craigyjp/Elka-X-VST-editor---Cherry-Audio/schematics/Synthex-Main.pdf

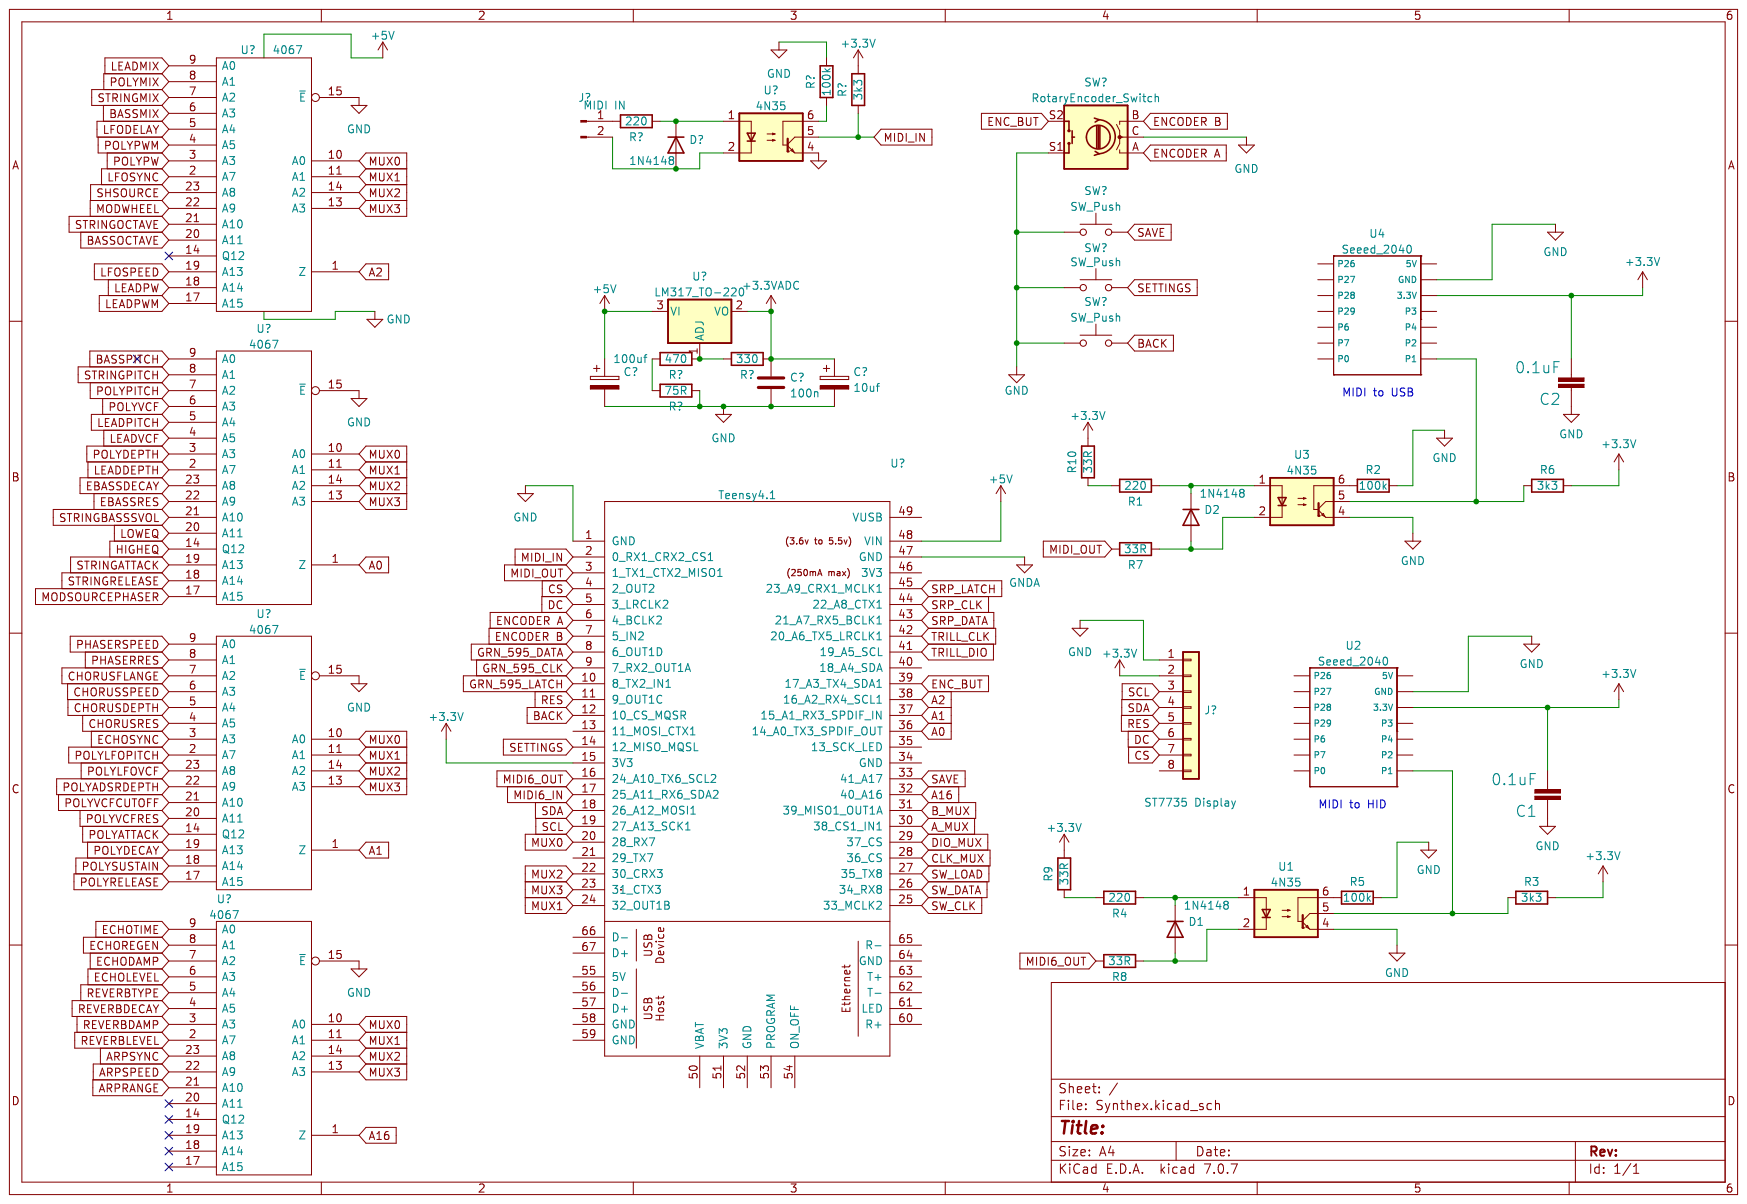
[picture p2: page 1]
