craigyjp/Elka-X-VST-editor---Cherry-Audio/schematics/Synthex-LED-DISPLAYS.pdf

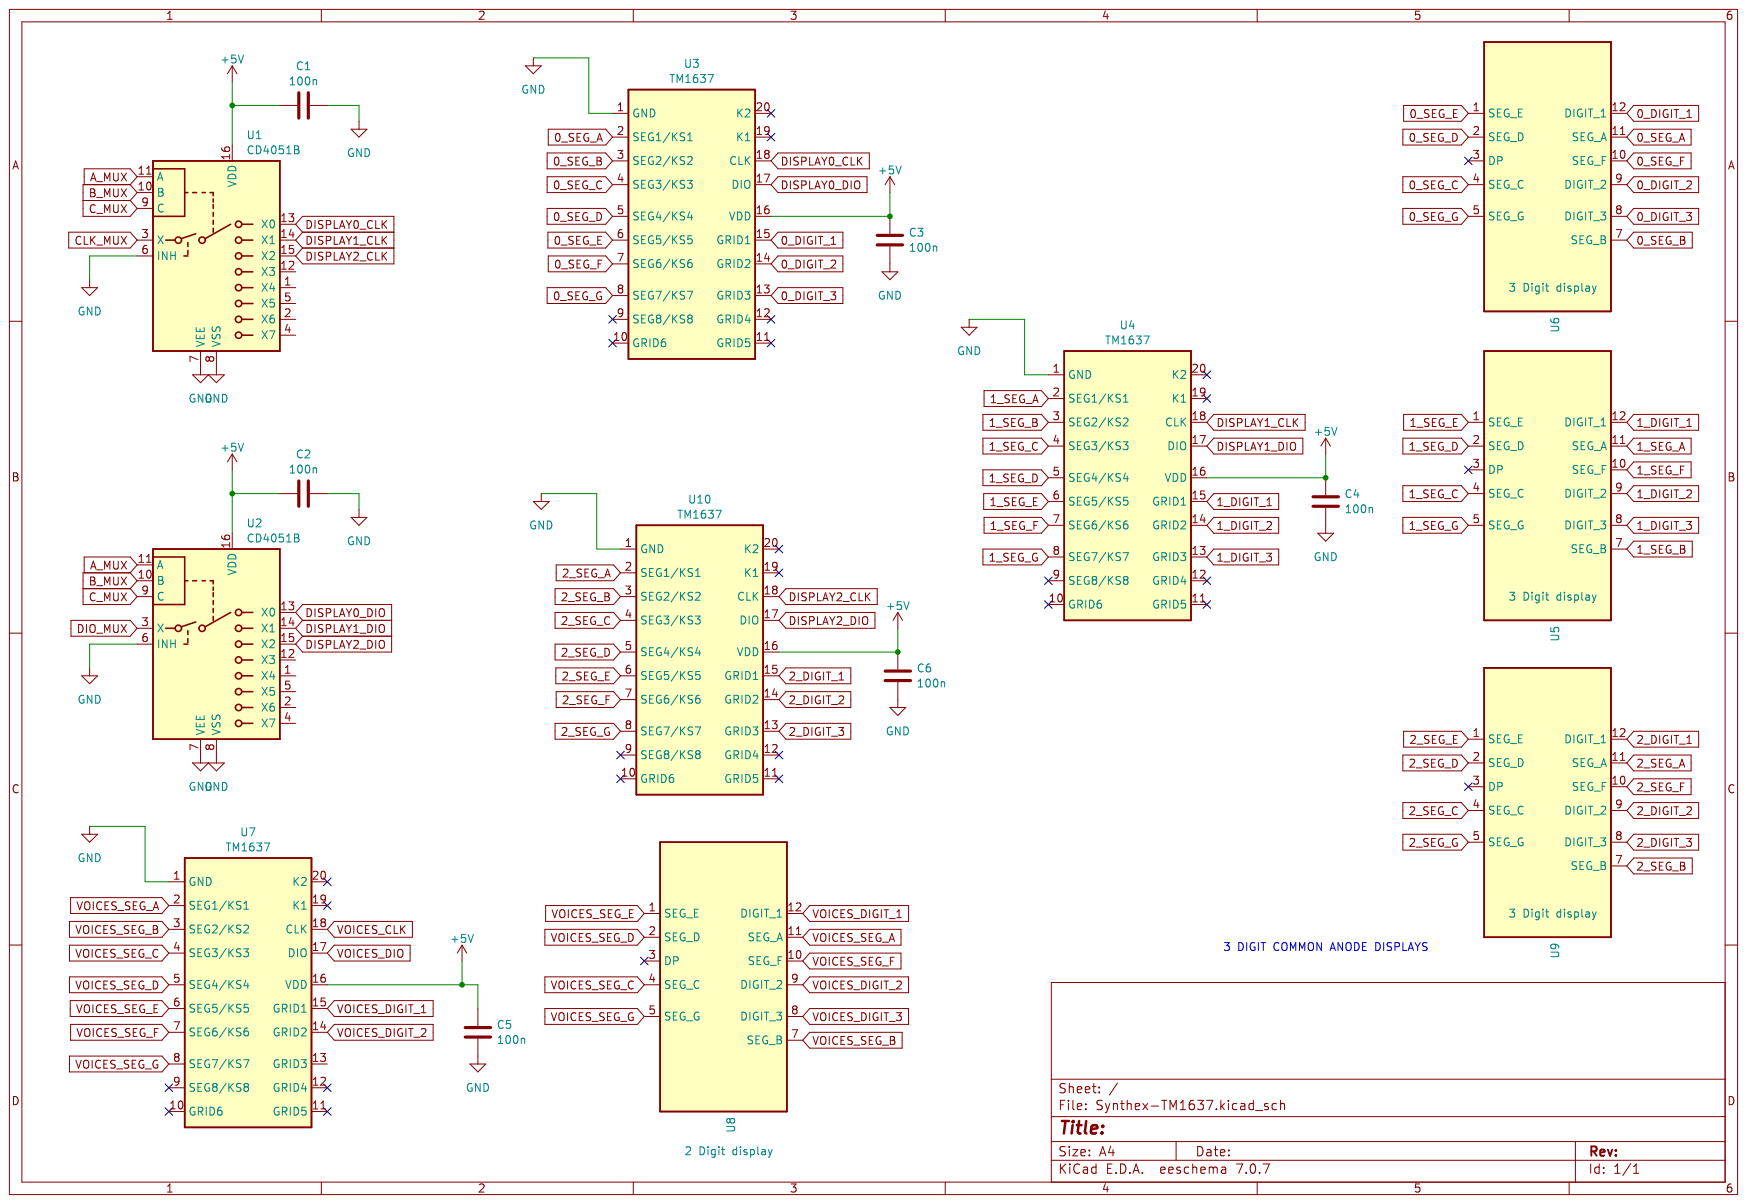
[picture p3: page 1]
