craigyjp/Elka-X-VST-editor---Cherry-Audio/src/Synthex.ino

/*
  Synthex Editor - Firmware Rev 1.0

  Includes code by:
    Dave Benn - Handling MUXs, a few other bits and original inspiration  https://www.notesandvolts.com/2019/01/teensy-synth-part-10-hardware.html
    ElectroTechnique for general method of menus and updates.

  Arduino IDE
  Tools Settings:
  Board: "Teensy4,1"
  USB Type: "Serial + MIDI"
  CPU Speed: "600"
  Optimize: "Fastest"

  Additional libraries:
    Agileware CircularBuffer available in Arduino libraries manager
    Replacement files are in the Modified Libraries folder and need to be placed in the teensy Audio folder.
*/

#include <Wire.h>
#include <SPI.h>
#include <SD.h>
#include <SerialFlash.h>
#include <MIDI.h>
#include <USBHost_t36.h>
#include "MidiCC.h"
#include "ButtonsPots.h"
#include "Constants.h"
#include "Parameters.h"
#include "PatchMgr.h"
#include "HWControls.h"
#include "EepromMgr.h"
#include <RoxMux.h>
#include <SevenSegmentTM1637.h>
#include <SevenSegmentExtended.h>

#define PARAMETER 0      //The main page for displaying the current patch and control (parameter) changes
#define RECALL 1         //Patches list
#define SAVE 2           //Save patch page
#define REINITIALISE 3   // Reinitialise message
#define PATCH 4          // Show current patch bypassing PARAMETER
#define PATCHNAMING 5    // Patch naming page
#define DELETE 6         //Delete patch page
#define DELETEMSG 7      //Delete patch message page
#define SETTINGS 8       //Settings page
#define SETTINGSVALUE 9  //Settings page

unsigned int state = PARAMETER;

#include "ST7735Display.h"

boolean cardStatus = false;

//USB HOST MIDI Class Compliant
USBHost myusb;
USBHub hub1(myusb);
USBHub hub2(myusb);
MIDIDevice midi1(myusb);

//MIDI 5 Pin DIN
MIDI_CREATE_INSTANCE(HardwareSerial, Serial1, MIDI);
MIDI_CREATE_INSTANCE(HardwareSerial, Serial6, MIDI6);

#define OCTO_TOTAL 14
#define BTN_DEBOUNCE 50
RoxOctoswitch<OCTO_TOTAL, BTN_DEBOUNCE> octoswitch;

// pins for 74HC165
#define PIN_DATA 34  // pin 9 on 74HC165 (DATA)
#define PIN_LOAD 35  // pin 1 on 74HC165 (LOAD)
#define PIN_CLK 33   // pin 2 on 74HC165 (CLK))

#define SR_TOTAL 13
Rox74HC595<SR_TOTAL> sr;

#define GREEN_TOTAL 10
Rox74HC595<GREEN_TOTAL> green;

// pins for 74HC595
#define LED_DATA 21   // pin 14 on 74HC595 (DATA)
#define LED_LATCH 23  // pin 12 on 74HC595 (LATCH)
#define LED_CLK 22    // pin 11 on 74HC595 (CLK)
#define LED_PWM -1    // pin 13 on 74HC595

// pins for 74HC595
#define GREEN_LED_DATA 6   // pin 14 on 74HC595 (DATA)
#define GREEN_LED_LATCH 8  // pin 12 on 74HC595 (LATCH)
#define GREEN_LED_CLK 7    // pin 11 on 74HC595 (CLK)
#define GREEN_LED_PWM -1   // pin 13 on 74HC595

//RoxLed UPPER_LED;

byte ccType = 0;  //(EEPROM)

#include "Settings.h"

int count = 0;                 //For MIDI Clk Sync
int patchNo = 1;               //Current patch no
int voiceToReturn = -1;        //Initialise
long earliestTime = millis();  //For voice allocation - initialise to now

// LED displays
SevenSegmentExtended trilldisplay(TRILL_CLK, TRILL_DIO);
SevenSegmentExtended display0(SEGMENT_CLK, SEGMENT_DIO);
SevenSegmentExtended display1(SEGMENT_CLK, SEGMENT_DIO);
SevenSegmentExtended display2(SEGMENT_CLK, SEGMENT_DIO);

void setup() {
  SPI.begin();
  octoswitch.begin(PIN_DATA, PIN_LOAD, PIN_CLK);
  octoswitch.setCallback(onButtonPress);
  octoswitch.setIgnoreAfterHold(UTILITY_SW, true);
  octoswitch.setIgnoreAfterHold(MAX_VOICES_SW, true);
  sr.begin(LED_DATA, LED_LATCH, LED_CLK, LED_PWM);
  green.begin(GREEN_LED_DATA, GREEN_LED_LATCH, GREEN_LED_CLK, GREEN_LED_PWM);
  setupDisplay();
  setUpSettings();
  setupHardware();
  //UPPER_LED.begin();
  //UPPER_LED.setMode(ROX_DEFAULT);
  //setUpLEDS();

  // Initialize the array with some values (optional)
  for (int i = 0; i < 128; i++) {
    for (int j = 0; j < 4; j++) {
      // Assign some values, for example, i * j
      seqArray[i][j] = -1;
    }
  }

  LEDintensity = getLEDintensity();
  LEDintensity = LEDintensity * 10;
  oldLEDintensity = LEDintensity;

  trilldisplay.begin();                     // initializes the display
  trilldisplay.setBacklight(LEDintensity);  // set the brightness to 100 %
  trilldisplay.print("   8");               // display INIT on the display
  delay(10);

  setLEDDisplay0();
  display0.begin();          // initializes the display
  display0.setBacklight(0);  // set the brightness to intensity
  display0.print(" 127");    // display INIT on the display
  delay(10);

  setLEDDisplay1();
  display1.begin();          // initializes the display
  display1.setBacklight(0);  // set the brightness to intensity
  display1.print("   0");    // display INIT on the display
  delay(10);

  setLEDDisplay2();
  display2.begin();                     // initializes the display
  display2.setBacklight(LEDintensity);  // set the brightness to intensity
  display2.print(" 127");               // display INIT on the display
  delay(10);

  setLEDDisplay0();

  cardStatus = SD.begin(BUILTIN_SDCARD);
  if (cardStatus) {
    Serial.println("SD card is connected");
    //Get patch numbers and names from SD card
    loadPatches();
    if (patches.size() == 0) {
      //save an initialised patch to SD card
      savePatch("1", INITPATCH);
      loadPatches();
    }
  } else {
    Serial.println("SD card is not connected or unusable");
    reinitialiseToPanel();
    showPatchPage("No SD", "conn'd / usable");
  }

  //Read MIDI Channel from EEPROM
  midiChannel = getMIDIChannel();
  Serial.println("MIDI Ch:" + String(midiChannel) + " (0 is Omni On)");

  //Read CC type from EEPROM
  ccType = getCCType();

  //Read UpdateParams type from EEPROM
  updateParams = getUpdateParams();

  //Read SendNotes type from EEPROM
  sendNotes = getSendNotes();

  //USB HOST MIDI Class Compliant
  delay(400);  //Wait to turn on USB Host
  myusb.begin();
  midi1.setHandleControlChange(myConvertControlChange);
  midi1.setHandleProgramChange(myProgramChange);
  midi1.setHandleNoteOff(myNoteOff);
  midi1.setHandleNoteOn(myNoteOn);
  midi1.setHandlePitchChange(myPitchBend);
  Serial.println("USB HOST MIDI Class Compliant Listening");

  //USB Client MIDI
  usbMIDI.setHandleControlChange(myConvertControlChange);
  usbMIDI.setHandleProgramChange(myProgramChange);
  usbMIDI.setHandleNoteOff(myNoteOff);
  usbMIDI.setHandleNoteOn(myNoteOn);
  usbMIDI.setHandlePitchChange(myPitchBend);
  Serial.println("USB Client MIDI Listening");

  //MIDI 5 Pin DIN
  MIDI.begin();
  MIDI.setHandleControlChange(myConvertControlChange);
  MIDI.setHandleProgramChange(myProgramChange);
  MIDI.setHandleNoteOn(myNoteOn);
  MIDI.setHandleNoteOff(myNoteOff);
  MIDI.setHandlePitchBend(myPitchBend);


  MIDI6.begin();
  Serial.println("MIDI In DIN Listening");

  //Read Encoder Direction from EEPROM
  encCW = getEncoderDir();
  //Read MIDI Out Channel from EEPROM
  midiOutCh = getMIDIOutCh();

  sr.writePin(UPPER_LED, HIGH);
  sr.writePin(SEQ_STOP_LED, HIGH);

  // Blank the split display
  setLEDDisplay2();
  display2.setBacklight(0);

  recallPatch(patchNo);  //Load first patch
}

void myNoteOn(byte channel, byte note, byte velocity) {
  // if (learning) {
  //   learningNote = note;
  //   noteArrived = true;
  // }

  if (!learning) {
    MIDI.sendNoteOn(note, velocity, channel);
    if (sendNotes) {
      usbMIDI.sendNoteOn(note, velocity, channel);
    }
  }

  if (chordMemoryWaitL) {
    chordMemoryWaitL = false;
    sr.writePin(CHORD_MEMORY_LED, LOW);
    green.writePin(GREEN_CHORD_MEMORY_LED, HIGH);
  }

  if (chordMemoryWaitU) {
    chordMemoryWaitU = false;
    sr.writePin(CHORD_MEMORY_LED, HIGH);
    green.writePin(GREEN_CHORD_MEMORY_LED, LOW);
  }
}

void myNoteOff(byte channel, byte note, byte velocity) {
  if (!learning) {
    MIDI.sendNoteOff(note, velocity, channel);
    if (sendNotes) {
      usbMIDI.sendNoteOff(note, velocity, channel);
    }
  }
}

void convertIncomingNote() {

  if (learning && noteArrived) {
    splitNote = learningNote;
    learning = false;
    noteArrived = false;
    sr.writePin(SPLIT_LED, HIGH);
    setLEDDisplay2();
    display2.setBacklight(LEDintensity);
    displayLEDNumber(2, splitNote);

    MIDI.sendNoteOn(splitNote, 127, 1);
    MIDI.sendNoteOff(splitNote, 0, 1);
  }
}

void myConvertControlChange(byte channel, byte number, byte value) {
  int newvalue = value;
  myControlChange(channel, number, newvalue);
}

void myPitchBend(byte channel, int bend) {
  MIDI.sendPitchBend(bend, channel);
  if (sendNotes) {
    usbMIDI.sendPitchBend(bend, channel);
  }
}

void myAfterTouch(byte channel, byte pressure) {
  MIDI.sendAfterTouch(pressure, channel);
  if (sendNotes) {
    usbMIDI.sendAfterTouch(pressure, channel);
  }
}

void allNotesOff() {
}

void updatemasterTune() {
  if (!recallPatchFlag) {
    showCurrentParameterPage("Tune", String(masterTunestr) + " Semi");
  }
  midiCCOut(MIDImasterTune, masterTune);
}

void updatemasterVolume() {
  if (!recallPatchFlag) {
    showCurrentParameterPage("Master Volume", String(masterVolumestr) + " %");
  }
  midiCCOut(MIDImasterVolume, masterVolume);
}

void updatelayerPan() {
  if (!recallPatchFlag) {
    showCurrentParameterPage("Layer Pan", String(layerPanstr) + " %");
  }
  if (upperSW) {
    midiCCOut(MIDIlayerPanU, layerPanU);
  }
  if (lowerSW) {
    midiCCOut(MIDIlayerPanL, layerPanL);
  }
}

void updatelayerVolume() {
  if (!recallPatchFlag) {
    showCurrentParameterPage("Layer Volume", String(layerVolumestr) + " %");
  }
  if (lowerSW) {
    midiCCOut(MIDIlayerVolumeL, layerVolumeL);
  }
  if (upperSW) {
    midiCCOut(MIDIlayerVolumeU, layerVolumeU);
  }
}

void updatereverbLevel() {
  if (!recallPatchFlag) {
    showCurrentParameterPage("Reverb Level", String(reverbLevelstr) + " %");
  }
  if (lowerSW) {
    midiCCOut(MIDIreverbLevelL, reverbLevelL);
  }
  if (upperSW) {
    midiCCOut(MIDIreverbLevelU, reverbLevelU);
  }
}

void updatereverbDecay() {
  if (!recallPatchFlag) {
    showCurrentParameterPage("Reverb Decay", String(reverbDecaystr) + " %");
  }
  if (lowerSW) {
    midiCCOut(MIDIreverbDecayL, reverbDecayL);
  }
  if (upperSW) {
    midiCCOut(MIDIreverbDecayU, reverbDecayU);
  }
}

void updatereverbEQ() {
  if (!recallPatchFlag) {
    showCurrentParameterPage("Reverb EQ", String(reverbEQstr) + " %");
  }
  if (lowerSW) {
    midiCCOut(MIDIreverbEQL, reverbEQL);
  }
  if (upperSW) {
    midiCCOut(MIDIreverbEQU, reverbEQU);
  }
}

void updatearpFrequency() {
  if (!recallPatchFlag) {
    if (lowerSW) {
      if (arpSyncSWL) {
        showCurrentParameterPage("Arp Sync", String(arpFrequencystring));
      } else {
        showCurrentParameterPage("Arp Frequency", String(arpFrequencystr) + " Hz");
      }
    }
    if (upperSW) {
      if (arpSyncSWU) {
        showCurrentParameterPage("Arp Sync", String(arpFrequencystring));
      } else {
        showCurrentParameterPage("Arp Frequency", String(arpFrequencystr) + " Hz");
      }
    }
  }

  if (lowerSW) {
    midiCCOut(MIDIarpFrequencyL, arpFrequencyL);
  }
  if (upperSW) {
    midiCCOut(MIDIarpFrequencyU, arpFrequencyU);
  }
}

void updateampVelocity() {
  if (!recallPatchFlag) {
    showCurrentParameterPage("Amp Velocity", String(ampVelocitystr) + " %");
  }
  if (lowerSW) {
    midiCCOut(MIDIampVelocityL, ampVelocityL);
  }
  if (upperSW) {
    midiCCOut(MIDIampVelocityU, ampVelocityU);
  }
}

void updatefilterVelocity() {
  if (!recallPatchFlag) {
    showCurrentParameterPage("Filter Velocity", String(filterVelocitystr) + " %");
  }
  if (lowerSW) {
    midiCCOut(MIDIfilterVelocityL, filterVelocityL);
  }
  if (upperSW) {
    midiCCOut(MIDIfilterVelocityU, filterVelocityU);
  }
}

void updateampRelease() {
  if (!recallPatchFlag) {
    showCurrentParameterPage("Amp Release", String(ampReleasestr) + " mS");
  }
  if (lowerSW) {
    midiCCOut(MIDIampReleaseL, ampReleaseL);
  }
  if (upperSW) {
    midiCCOut(MIDIampReleaseU, ampReleaseU);
  }
}

void updateampSustain() {
  if (!recallPatchFlag) {
    showCurrentParameterPage("Amp Sustain", String(ampSustainstr) + " mS");
  }
  if (lowerSW) {
    midiCCOut(MIDIampSustainL, ampSustainL);
  }
  if (upperSW) {
    midiCCOut(MIDIampSustainU, ampSustainU);
  }
}

void updateampDecay() {
  if (!recallPatchFlag) {
    showCurrentParameterPage("Amp Decay", String(ampDecaystr) + " mS");
  }
  if (lowerSW) {
    midiCCOut(MIDIampDecayU, ampDecayL);
  }
  if (upperSW) {
    midiCCOut(MIDIampDecayU, ampDecayU);
  }
}

void updateampAttack() {
  if (!recallPatchFlag) {
    showCurrentParameterPage("Amp Attack", String(ampAttackstr) + " mS");
  }
  if (lowerSW) {
    midiCCOut(MIDIampAttackL, ampAttackL);
  }
  if (upperSW) {
    midiCCOut(MIDIampAttackU, ampAttackU);
  }
}

void updatefilterKeyboard() {
  if (!recallPatchFlag) {
    showCurrentParameterPage("Key Track", String(filterKeyboardstr) + " %");
  }
  if (lowerSW) {
    midiCCOut(MIDIfilterKeyboardU, filterKeyboardL);
  }
  if (upperSW) {
    midiCCOut(MIDIfilterKeyboardU, filterKeyboardU);
  }
}

void updatefilterResonance() {
  if (!recallPatchFlag) {
    showCurrentParameterPage("Filter Res", String(filterResonancestr) + " %");
  }
  if (lowerSW) {
    midiCCOut(MIDIfilterResonanceL, filterResonanceL);
  }
  if (upperSW) {
    midiCCOut(MIDIfilterResonanceU, filterResonanceU);
  }
}

void updateosc2Volume() {
  if (!recallPatchFlag) {
    showCurrentParameterPage("Osc2 Volume", String(osc2Volumestr) + " %");
  }
  if (lowerSW) {
    midiCCOut(MIDIosc2VolumeL, osc2VolumeL);
  }
  if (upperSW) {
    midiCCOut(MIDIosc2VolumeU, osc2VolumeU);
  }
}

void updateosc2PW() {
  if (!recallPatchFlag) {
    showCurrentParameterPage("Osc2 PW", String(osc2PWstr) + " %");
  }
  if (lowerSW) {
    midiCCOut(MIDIosc2PWL, osc2PWL);
  }
  if (upperSW) {
    midiCCOut(MIDIosc2PWU, osc2PWU);
  }
}

void updateosc1PW() {
  if (!recallPatchFlag) {
    showCurrentParameterPage("Osc1 PW", String(osc1PWstr) + " %");
  }
  if (lowerSW) {
    midiCCOut(MIDIosc1PWL, osc1PWL);
  }
  if (upperSW) {
    midiCCOut(MIDIosc1PWU, osc1PWU);
  }
}

void updateosc1Volume() {
  if (!recallPatchFlag) {
    showCurrentParameterPage("Osc1 Volume", String(osc1Volumestr) + " %");
  }
  if (lowerSW) {
    midiCCOut(MIDIosc1VolumeL, osc1VolumeL);
  }
  if (upperSW) {
    midiCCOut(MIDIosc1VolumeU, osc1VolumeU);
  }
}

void updatefilterCutoff() {
  if (!recallPatchFlag) {
    showCurrentParameterPage("Filter Cutoff", String(filterCutoffstr) + " Hz");
  }
  if (lowerSW) {
    midiCCOut(MIDIfilterCutoffL, filterCutoffL);
  }
  if (upperSW) {
    midiCCOut(MIDIfilterCutoffU, filterCutoffU);
  }
}

void updatefilterEnvAmount() {
  if (!recallPatchFlag) {
    showCurrentParameterPage("Filter Envelope", String(filterEnvAmountstr) + " %");
  }
  if (lowerSW) {
    midiCCOut(MIDIfilterEnvAmountL, filterEnvAmountL);
  }
  if (upperSW) {
    midiCCOut(MIDIfilterEnvAmountU, filterEnvAmountU);
  }
}

void updatefilterAttack() {
  if (!recallPatchFlag) {
    showCurrentParameterPage("Filter Attack", String(filterAttackstr) + " mS");
  }
  if (lowerSW) {
    midiCCOut(MIDIfilterAttackL, filterAttackL);
  }
  if (upperSW) {
    midiCCOut(MIDIfilterAttackU, filterAttackU);
  }
}

void updatefilterDecay() {
  if (!recallPatchFlag) {
    showCurrentParameterPage("Filter Decay", String(filterDecaystr) + " mS");
  }
  if (lowerSW) {
    midiCCOut(MIDIfilterDecayL, filterDecayL);
  }
  if (upperSW) {
    midiCCOut(MIDIfilterDecayU, filterDecayU);
  }
}

void updatefilterSustain() {
  if (!recallPatchFlag) {
    showCurrentParameterPage("Filter Sustain", String(filterSustainstr) + " mS");
  }
  if (lowerSW) {
    midiCCOut(MIDIfilterSustainL, filterSustainL);
  }
  if (upperSW) {
    midiCCOut(MIDIfilterSustainU, filterSustainU);
  }
}

void updatefilterRelease() {
  if (!recallPatchFlag) {
    showCurrentParameterPage("Filter Release", String(filterReleasestr) + " mS");
  }
  if (lowerSW) {
    midiCCOut(MIDIfilterReleaseU, filterReleaseL);
  }
  if (upperSW) {
    midiCCOut(MIDIfilterReleaseU, filterReleaseU);
  }
}

void updateechoEQ() {
  if (!recallPatchFlag) {
    showCurrentParameterPage("Echo EQ", String(echoEQstr) + " %");
  }
  if (lowerSW) {
    midiCCOut(MIDIechoEQL, echoEQL);
  }
  if (upperSW) {
    midiCCOut(MIDIechoEQU, echoEQU);
  }
}

void updateechoLevel() {
  if (!recallPatchFlag) {
    showCurrentParameterPage("Echo Level", String(echoLevelstr) + " %");
  }
  if (lowerSW) {
    midiCCOut(MIDIechoLevelL, echoLevelL);
  }
  if (upperSW) {
    midiCCOut(MIDIechoLevelU, echoLevelU);
  }
}

void updateechoFeedback() {
  if (!recallPatchFlag) {
    showCurrentParameterPage("Echo Feedbck", String(echoFeedbackstr) + " %");
  }
  if (lowerSW) {
    midiCCOut(MIDIechoFeedbackL, echoFeedbackL);
  }
  if (upperSW) {
    midiCCOut(MIDIechoFeedbackU, echoFeedbackU);
  }
}

void updateechoSpread() {
  if (!recallPatchFlag) {
    showCurrentParameterPage("Echo Spread", String(echoSpreadstr) + " %");
  }
  if (lowerSW) {
    midiCCOut(MIDIechoSpreadL, echoSpreadL);
  }
  if (upperSW) {
    midiCCOut(MIDIechoSpreadU, echoSpreadU);
  }
}

void updateechoTime() {
  if (!recallPatchFlag) {
    if (lowerSW) {
      if (echoSyncSWL) {
        showCurrentParameterPage("Echo Sync", String(echoTimestring));
      } else {
        showCurrentParameterPage("Echo Time", String(echoTimestr) + " Hz");
      }
    }
    if (upperSW) {
      if (echoSyncSWU) {
        showCurrentParameterPage("Echo Sync", String(echoTimestring));
      } else {
        showCurrentParameterPage("Echo Time", String(echoTimestr) + " Hz");
      }
    }
  }
  if (lowerSW) {
    midiCCOut(MIDIechoTimeL, echoTimeL);
  }
  if (upperSW) {
    midiCCOut(MIDIechoTimeU, echoTimeU);
  }
}

void updatelfo2Destination() {
  if (!recallPatchFlag) {
    switch (lfo2Destinationstr) {
      case 0:
        showCurrentParameterPage("LFO2 Dest", "Lower");
        break;

      case 1:
        showCurrentParameterPage("LFO2 Dest", "Both");
        break;

      case 2:
        showCurrentParameterPage("LFO2 Dest", "Upper");
        break;
    }
  }
  midiCCOut(MIDIlfo2UpperLower, lfo2Destination);
}

void updateunisonDetune() {
  if (!recallPatchFlag) {
    showCurrentParameterPage("Unison Detune", String(unisonDetunestr) + " %");
  }
  if (lowerSW) {
    midiCCOut(MIDIunisonDetuneL, unisonDetuneL);
  }
  if (upperSW) {
    midiCCOut(MIDIunisonDetuneU, unisonDetuneU);
  }
}

void updateglideSpeed() {
  if (!recallPatchFlag) {
    showCurrentParameterPage("Glide Speed", String(glideSpeedstr) + " mS");
  }
  if (lowerSW) {
    midiCCOut(MIDIglideSpeedL, glideSpeedL);
  }
  if (upperSW) {
    midiCCOut(MIDIglideSpeedU, glideSpeedU);
  }
}

void updateosc1Transpose() {
  if (!recallPatchFlag) {
    showCurrentParameterPage("OSC1 Trans", String(osc1Transposestr) + " Semi");
  }
  if (lowerSW) {
    midiCCOut(MIDIosc1TransposeL, osc1TransposeL);
  }
  if (upperSW) {
    midiCCOut(MIDIosc1TransposeU, osc1TransposeU);
  }
}

void updateosc2Transpose() {
  if (!recallPatchFlag) {
    showCurrentParameterPage("OSC2 Trans", String(osc2Transposestr) + " Semi");
  }
  if (lowerSW) {
    midiCCOut(MIDIosc2TransposeL, osc2TransposeL);
  }
  if (upperSW) {
    midiCCOut(MIDIosc2TransposeU, osc2TransposeU);
  }
}

void updatenoiseLevel() {
  if (!recallPatchFlag) {
    showCurrentParameterPage("Noise Level", String(noiseLevelstr) + " %");
  }
  if (lowerSW) {
    midiCCOut(MIDInoiseLevelL, noiseLevelL);
  }
  if (upperSW) {
    midiCCOut(MIDInoiseLevelU, noiseLevelU);
  }
}

void updateglideAmount() {
  if (!recallPatchFlag) {
    showCurrentParameterPage("Glide Amount", String(glideAmountstr) + " Cents");
  }
  if (lowerSW) {
    midiCCOut(MIDIglideAmountL, glideAmountL);
  }
  if (upperSW) {
    midiCCOut(MIDIglideAmountU, glideAmountU);
  }
}

void updateosc1Tune() {
  if (!recallPatchFlag) {
    showCurrentParameterPage("OSC1 Tune", String(osc1Tunestr) + " Cents");
  }
  if (lowerSW) {
    midiCCOut(MIDIosc1TuneL, osc1TuneL);
  }
  if (upperSW) {
    midiCCOut(MIDIosc1TuneU, osc1TuneU);
  }
}

void updateosc2Tune() {
  if (!recallPatchFlag) {
    showCurrentParameterPage("OSC2 Tune", String(osc2Tunestr) + " Cents");
  }
  if (lowerSW) {
    midiCCOut(MIDIosc2TuneL, osc2TuneL);
  }
  if (upperSW) {
    midiCCOut(MIDIosc2TuneU, osc2TuneU);
  }
}

void updatebendToFilter() {
  if (!recallPatchFlag) {
    showCurrentParameterPage("Bend to Filter", String(bendToFilterstr) + " %");
  }
  midiCCOut(MIDIbendToFilter, bendToFilter);
}

void updatelfo2ToFilter() {
  if (!recallPatchFlag) {
    showCurrentParameterPage("LFO2 to Filter", String(lfo2ToFilterstr) + " %");
  }
  midiCCOut(MIDIlfo2ToFilter, lfo2ToFilter);
}

void updatebendToOsc() {
  if (!recallPatchFlag) {
    showCurrentParameterPage("Bend to OSC", String(bendToOscstr) + " Semi");
  }
  midiCCOut(MIDIbendToOsc, bendToOsc);
}

void updatelfo2ToOsc() {
  if (!recallPatchFlag) {
    showCurrentParameterPage("LFO2 to OSC", String(lfo2ToOscstr) + " %");
  }
  midiCCOut(MIDIlfo2ToOsc, lfo2ToOsc);
}

void updatelfo2FreqAcc() {
  if (!recallPatchFlag) {
    showCurrentParameterPage("LFO2 Freq Acc", String(lfo2FreqAccstr) + " %");
  }
  midiCCOut(MIDIlfo2FreqAcc, lfo2FreqAcc);
}

void updatelfo2InitFrequency() {
  if (!recallPatchFlag) {
    if (lfo2SyncSW) {
      showCurrentParameterPage("LFO2 SYNC", String(lfo2InitFrequencystring));
    } else {
      showCurrentParameterPage("LFO2 Freq", String(lfo2InitFrequencystr) + " Hz");
    }
  }
  midiCCOut(MIDIlfo2InitFrequency, lfo2InitFrequency);
}

void updatelfo2InitAmount() {
  if (!recallPatchFlag) {
    showCurrentParameterPage("LFO2 Init Amnt", String(lfo2InitAmountstr) + " %");
  }
  midiCCOut(MIDIlfo2InitAmount, lfo2InitAmount);
}

void updateseqAssign() {
  if (!recallPatchFlag) {
    switch (seqAssignstr) {
      case 0:
        showCurrentParameterPage("Seq Assign", "Lower");
        break;

      case 1:
        showCurrentParameterPage("Seq Assign", "Upper");
        break;
    }
  }
  midiCCOut(CCseqAssign, seqAssign);
}

void updateseqRate() {
  if (!recallPatchFlag) {
    showCurrentParameterPage("Seq Rate", String(seqRatestr) + " %");
  }
  midiCCOut(CCseqRate, seqRate);
}

void updateseqGate() {
  if (!recallPatchFlag) {
    showCurrentParameterPage("Seq Gate", String(seqGatestr) + " %");
  }
  midiCCOut(CCseqGate, seqGate);
}

void updatelfo1Frequency() {
  if (!recallPatchFlag) {
    if (lowerSW) {
      if (lfo1SyncSWL) {
        showCurrentParameterPage("LFO1 SYNC", String(lfo1Frequencystring));
      } else {
        showCurrentParameterPage("LFO1 Freq", String(lfo1Frequencystr) + " Hz");
      }
    }
    if (upperSW) {
      if (lfo1SyncSWU) {
        showCurrentParameterPage("LFO1 SYNC", String(lfo1Frequencystring));
      } else {
        showCurrentParameterPage("LFO1 Freq", String(lfo1Frequencystr) + " Hz");
      }
    }
  }
  if (lowerSW) {
    midiCCOut(MIDIlfo1FrequencyL, lfo1FrequencyL);
  }
  if (upperSW) {
    midiCCOut(MIDIlfo1FrequencyU, lfo1FrequencyU);
  }
}

void updatelfo1DepthA() {
  if (!recallPatchFlag) {
    showCurrentParameterPage("LFO1 Depth A", String(lfo1DepthAstr) + " %");
  }
  if (lowerSW) {
    midiCCOut(MIDIlfo1DepthAL, lfo1DepthAL);
  }
  if (upperSW) {
    midiCCOut(MIDIlfo1DepthAU, lfo1DepthAU);
  }
}

void updatelfo1Delay() {
  if (!recallPatchFlag) {
    showCurrentParameterPage("LFO1 Delay", String(lfo1Delaystr) + " mS");
  }
  if (lowerSW) {
    midiCCOut(MIDIlfo1DelayL, lfo1DelayL);
  }
  if (upperSW) {
    midiCCOut(MIDIlfo1DelayU, lfo1DelayU);
  }
}

void updatelfo1DepthB() {
  if (!recallPatchFlag) {
    showCurrentParameterPage("LFO1 Depth B", String(lfo1DepthBstr) + " %");
  }
  if (lowerSW) {
    midiCCOut(MIDIlfo1DepthBL, lfo1DepthBL);
  }
  if (upperSW) {
    midiCCOut(MIDIlfo1DepthBU, lfo1DepthBU);
  }
}

void updatearpRange4SW() {
  if (!recallPatchFlag) {
    showCurrentParameterPage("ARP Range", "4 Octaves");
  }
  if (arpRange4SWL && lowerSW) {
    green.writePin(GREEN_ARP_RANGE_4_LED, HIGH);
    green.writePin(GREEN_ARP_RANGE_3_LED, LOW);
    green.writePin(GREEN_ARP_RANGE_2_LED, LOW);
    green.writePin(GREEN_ARP_RANGE_1_LED, LOW);
    sr.writePin(ARP_RANGE_4_LED, LOW);
    sr.writePin(ARP_RANGE_3_LED, LOW);
    sr.writePin(ARP_RANGE_2_LED, LOW);
    sr.writePin(ARP_RANGE_1_LED, LOW);
    arpRange3SWL = 0;
    arpRange2SWL = 0;
    arpRange1SWL = 0;
  }
  if (arpRange4SWU && upperSW) {
    green.writePin(GREEN_ARP_RANGE_4_LED, LOW);
    sr.writePin(ARP_RANGE_4_LED, HIGH);
    sr.writePin(ARP_RANGE_3_LED, LOW);
    sr.writePin(ARP_RANGE_2_LED, LOW);
    sr.writePin(ARP_RANGE_1_LED, LOW);
    green.writePin(GREEN_ARP_RANGE_4_LED, LOW);
    green.writePin(GREEN_ARP_RANGE_3_LED, LOW);
    green.writePin(GREEN_ARP_RANGE_2_LED, LOW);
    green.writePin(GREEN_ARP_RANGE_1_LED, LOW);
    arpRange3SWU = 0;
    arpRange2SWU = 0;
    arpRange1SWU = 0;
  }

  if (!layerPatchFlag) {
    if (upperSW && arpRange4SWU) {
      midiCCOut(MIDIarpRangeU, 65);
    }
    if (lowerSW && arpRange4SWL) {
      midiCCOut(MIDIarpRangeL, 65);
    }
  }
}

void updatearpRange3SW() {
  if (!recallPatchFlag) {
    showCurrentParameterPage("ARP Range", "3 Octaves");
  }
  if (arpRange3SWL && lowerSW) {
    green.writePin(GREEN_ARP_RANGE_3_LED, HIGH);
    green.writePin(GREEN_ARP_RANGE_4_LED, LOW);
    green.writePin(GREEN_ARP_RANGE_2_LED, LOW);
    green.writePin(GREEN_ARP_RANGE_1_LED, LOW);
    sr.writePin(ARP_RANGE_4_LED, LOW);
    sr.writePin(ARP_RANGE_3_LED, LOW);
    sr.writePin(ARP_RANGE_2_LED, LOW);
    sr.writePin(ARP_RANGE_1_LED, LOW);
    arpRange4SWL = 0;
    arpRange2SWL = 0;
    arpRange1SWL = 0;
  }
  if (arpRange3SWU && upperSW) {
    sr.writePin(ARP_RANGE_3_LED, HIGH);
    sr.writePin(ARP_RANGE_4_LED, LOW);
    sr.writePin(ARP_RANGE_2_LED, LOW);
    sr.writePin(ARP_RANGE_1_LED, LOW);
    green.writePin(GREEN_ARP_RANGE_4_LED, LOW);
    green.writePin(GREEN_ARP_RANGE_3_LED, LOW);
    green.writePin(GREEN_ARP_RANGE_2_LED, LOW);
    green.writePin(GREEN_ARP_RANGE_1_LED, LOW);
    arpRange4SWU = 0;
    arpRange2SWU = 0;
    arpRange1SWU = 0;
  }

  if (!layerPatchFlag) {
    if (upperSW && arpRange3SWU) {
      midiCCOut(MIDIarpRangeU, 75);
    }
    if (lowerSW && arpRange3SWL) {
      midiCCOut(MIDIarpRangeL, 75);
    }
  }
}

void updatearpRange2SW() {
  if (!recallPatchFlag) {
    showCurrentParameterPage("ARP Range", "2 Octaves");
  }
  if (arpRange2SWL && lowerSW) {
    green.writePin(GREEN_ARP_RANGE_3_LED, LOW);
    green.writePin(GREEN_ARP_RANGE_4_LED, LOW);
    green.writePin(GREEN_ARP_RANGE_2_LED, HIGH);
    green.writePin(GREEN_ARP_RANGE_1_LED, LOW);
    sr.writePin(ARP_RANGE_4_LED, LOW);
    sr.writePin(ARP_RANGE_3_LED, LOW);
    sr.writePin(ARP_RANGE_2_LED, LOW);
    sr.writePin(ARP_RANGE_1_LED, LOW);
    arpRange4SWL = 0;
    arpRange3SWL = 0;
    arpRange1SWL = 0;
  }
  if (arpRange2SWU && upperSW) {
    sr.writePin(ARP_RANGE_3_LED, LOW);
    sr.writePin(ARP_RANGE_4_LED, LOW);
    sr.writePin(ARP_RANGE_2_LED, HIGH);
    sr.writePin(ARP_RANGE_1_LED, LOW);
    green.writePin(GREEN_ARP_RANGE_4_LED, LOW);
    green.writePin(GREEN_ARP_RANGE_3_LED, LOW);
    green.writePin(GREEN_ARP_RANGE_2_LED, LOW);
    green.writePin(GREEN_ARP_RANGE_1_LED, LOW);
    arpRange4SWU = 0;
    arpRange3SWU = 0;
    arpRange1SWU = 0;
  }

  if (!layerPatchFlag) {
    if (upperSW && arpRange2SWU) {
      midiCCOut(MIDIarpRangeU, 85);
    }
    if (lowerSW && arpRange2SWL) {
      midiCCOut(MIDIarpRangeL, 85);
    }
  }
}

void updatearpRange1SW() {
  if (!recallPatchFlag) {
    showCurrentParameterPage("ARP Range", "1 Octave");
  }
  if (arpRange1SWL && lowerSW) {
    green.writePin(GREEN_ARP_RANGE_3_LED, LOW);
    green.writePin(GREEN_ARP_RANGE_4_LED, LOW);
    green.writePin(GREEN_ARP_RANGE_2_LED, LOW);
    green.writePin(GREEN_ARP_RANGE_1_LED, HIGH);
    sr.writePin(ARP_RANGE_4_LED, LOW);
    sr.writePin(ARP_RANGE_3_LED, LOW);
    sr.writePin(ARP_RANGE_2_LED, LOW);
    sr.writePin(ARP_RANGE_1_LED, LOW);
    arpRange4SWL = 0;
    arpRange2SWL = 0;
    arpRange3SWL = 0;
  }
  if (arpRange1SWU && upperSW) {
    sr.writePin(ARP_RANGE_3_LED, LOW);
    sr.writePin(ARP_RANGE_4_LED, LOW);
    sr.writePin(ARP_RANGE_2_LED, LOW);
    sr.writePin(ARP_RANGE_1_LED, HIGH);
    green.writePin(GREEN_ARP_RANGE_4_LED, LOW);
    green.writePin(GREEN_ARP_RANGE_3_LED, LOW);
    green.writePin(GREEN_ARP_RANGE_2_LED, LOW);
    green.writePin(GREEN_ARP_RANGE_1_LED, LOW);
    arpRange4SWU = 0;
    arpRange3SWU = 0;
    arpRange2SWU = 0;
  }

  if (!layerPatchFlag) {
    if (upperSW && arpRange1SWU) {
      midiCCOut(MIDIarpRangeU, 97);
    }
    if (lowerSW && arpRange1SWL) {
      midiCCOut(MIDIarpRangeL, 97);
    }
  }
}

void updatearpSyncSW() {

  if (arpSyncSWL && lowerSW) {
    green.writePin(GREEN_ARP_SYNC_LED, HIGH);
    sr.writePin(ARP_SYNC_LED, LOW);
    if (!recallPatchFlag) {
      showCurrentParameterPage("ARP Sync", "Lower On");
    }
    if (!layerPatchFlag) {
      midiCCOut(MIDIarpSyncL, 127);
    }
    arpSyncSW = 1;
  }
  if (!arpSyncSWL && lowerSW) {
    green.writePin(GREEN_ARP_SYNC_LED, LOW);
    sr.writePin(ARP_SYNC_LED, LOW);
    if (!recallPatchFlag) {
      showCurrentParameterPage("ARP Sync", "Lower Off");
      if (!layerPatchFlag) {
        midiCCOut(MIDIarpSyncL, 127);
      }
    }
    arpSyncSW = 0;
  }
  if (arpSyncSWU && upperSW) {
    sr.writePin(ARP_SYNC_LED, HIGH);
    green.writePin(GREEN_ARP_SYNC_LED, LOW);
    if (!recallPatchFlag) {
      showCurrentParameterPage("ARP Sync", "Upper On");
    }
    if (!layerPatchFlag) {
      midiCCOut(MIDIarpSyncU, 127);
    }
    arpSyncSW = 1;
  }
  if (!arpSyncSWU && upperSW) {
    sr.writePin(ARP_SYNC_LED, LOW);
    green.writePin(GREEN_ARP_SYNC_LED, LOW);
    if (!recallPatchFlag) {
      showCurrentParameterPage("ARP Sync", "Upper Off");
      if (!layerPatchFlag) {
        midiCCOut(MIDIarpSyncU, 127);
      }
    }
    arpSyncSW = 0;
  }
}

void updatearpHoldSW() {

  if (arpHoldSWL && lowerSW) {
    green.writePin(GREEN_ARP_HOLD_LED, HIGH);
    sr.writePin(ARP_HOLD_LED, LOW);
    if (!recallPatchFlag) {
      showCurrentParameterPage("ARP Hold", "Lower On");
    }
    if (!layerPatchFlag) {
      midiCCOut(MIDIarpHoldL, 127);
    }
    arpHoldSW = 1;
  }
  if (!arpHoldSWL && lowerSW) {
    green.writePin(GREEN_ARP_HOLD_LED, LOW);
    sr.writePin(ARP_HOLD_LED, LOW);
    if (!recallPatchFlag) {
      showCurrentParameterPage("ARP Hold", "Lower Off");
      if (!layerPatchFlag) {
        midiCCOut(MIDIarpHoldL, 127);
      }
    }
    arpHoldSW = 0;
  }
  if (arpHoldSWU && upperSW) {
    sr.writePin(ARP_HOLD_LED, HIGH);
    green.writePin(GREEN_ARP_HOLD_LED, LOW);
    if (!recallPatchFlag) {
      showCurrentParameterPage("ARP Hold", "Upper On");
    }
    if (!layerPatchFlag) {
      midiCCOut(MIDIarpHoldU, 127);
    }
    arpHoldSW = 1;
  }
  if (!arpHoldSWU && upperSW) {
    sr.writePin(ARP_HOLD_LED, LOW);
    green.writePin(GREEN_ARP_HOLD_LED, LOW);
    if (!recallPatchFlag) {
      showCurrentParameterPage("ARP Hold", "Upper Off");
      if (!layerPatchFlag) {
        midiCCOut(MIDIarpHoldU, 127);
      }
    }
    arpHoldSW = 0;
  }
}

void updatelayerSoloSW() {

  if (layerSoloSW) {
    if (lowerSW) {
      green.writePin(GREEN_LAYER_SOLO_LED, HIGH);
      sr.writePin(LAYER_SOLO_LED, LOW);
    }
    if (upperSW) {
      green.writePin(GREEN_LAYER_SOLO_LED, LOW);
      sr.writePin(LAYER_SOLO_LED, HIGH);
    }
    if (!recallPatchFlag) {
      showCurrentParameterPage("Layer Solo", "On");
    }
  }
  if (!layerSoloSW) {
    green.writePin(GREEN_LAYER_SOLO_LED, LOW);
    sr.writePin(LAYER_SOLO_LED, LOW);
    if (!recallPatchFlag) {
      showCurrentParameterPage("Layer Solo", "Off");
    }
    if (upperSW) {
      sr.writePin(UPPER_LED, HIGH);
    }
    if (lowerSW) {
      sr.writePin(LOWER_LED, HIGH);
    }
  }

  if (!layerPatchFlag) {
    midiCCOut(MIDIlayerSolo, 127);
  }
}

void updatemaxVoicesSW() {

  if (maxVoicesSW == 1 && maxVoicesFirstPress == 0) {
    maxVoices_timer = millis();
    maxVoices = 2;
    if (!recallPatchFlag) {
      showCurrentParameterPage("Max Voices", maxVoices);
    }
    midi6CCOut(MIDImaxVoicesSW, 127);
    midi6CCOut(MIDIDownArrow, 127);
    maxVoicesFirstPress++;
    updateMaxVoicesDisplay(maxVoices);
  } else if (maxVoicesSW == 1 && maxVoicesFirstPress > 0) {
    maxVoices++;
    if (maxVoices > 16) {
      maxVoices = 2;
    }
    updateMaxVoicesDisplay(maxVoices);
    if (!recallPatchFlag) {
      showCurrentParameterPage("Max Voices", maxVoices);
    }
    midi6CCOut(MIDIDownArrow, 127);
    maxVoicesFirstPress++;
  }
}

void updatemaxVoicesExitSW() {
  if (maxVoicesExitSW == 1) {
    if (!recallPatchFlag) {
      showCurrentParameterPage("Max Voices", maxVoices);
    }
    midi6CCOut(MIDIEnter, 127);
    maxVoicesFirstPress = 0;
    maxVoicesSW = 0;
    updateMaxVoicesDisplay(maxVoices);
  }
}

void updateMaxVoicesDisplay(int maxVoices) {
  switch (maxVoices) {
    case 2:
      trilldisplay.print("   2");
      break;
    case 3:
      trilldisplay.print("   3");
      break;
    case 4:
      trilldisplay.print("   4");
      break;
    case 5:
      trilldisplay.print("   5");
      break;
    case 6:
      trilldisplay.print("   6");
      break;
    case 7:
      trilldisplay.print("   7");
      break;
    case 8:
      trilldisplay.print("   8");
      break;
    case 9:
      trilldisplay.print("   9");
      break;
    case 10:
      trilldisplay.print("  10");
      break;
    case 11:
      trilldisplay.print("  11");
      break;
    case 12:
      trilldisplay.print("  12");
      break;
    case 13:
      trilldisplay.print("  13");
      break;
    case 14:
      trilldisplay.print("  14");
      break;
    case 15:
      trilldisplay.print("  15");
      break;
    case 16:
      trilldisplay.print("  16");
      break;
  }
}

void updateLowerSW() {
  if (lowerSW == 1) {
    if (!recallPatchFlag) {
      showCurrentParameterPage("Lower", "On");
    }
    sr.writePin(LOWER_LED, HIGH);
    sr.writePin(UPPER_LED, LOW);
    upperSW = 0;
    if (layerSoloSW) {
      lower_timer = millis();
    }
    midiCCOut(MIDIpanel, 100);
    switchLEDs();
  }
}

void updateUpperSW() {
  if (upperSW == 1) {
    if (!recallPatchFlag) {
      showCurrentParameterPage("Upper", "On");
    }
    sr.writePin(LOWER_LED, LOW);
    sr.writePin(UPPER_LED, HIGH);
    lowerSW = 0;
    if (layerSoloSW) {
      upper_timer = millis();
    }
    midiCCOut(MIDIpanel, 50);
    switchLEDs();
  }
}

void updatelimiterSW() {
  if (limiterSW) {
    if (!recallPatchFlag) {
      showCurrentParameterPage("Limiter", "On");
    }
    sr.writePin(LIMITER_LED, HIGH);
    midiCCOut(MIDIlimiter, 127);
  }
  if (!limiterSW) {
    if (!recallPatchFlag) {
      showCurrentParameterPage("Limiter", "Off");
    }
    sr.writePin(LIMITER_LED, LOW);
    midiCCOut(MIDIlimiter, 127);
  }
}

void updateseqPlaySW() {
  if (seqPlaySW) {
    if (!recallPatchFlag) {
      showCurrentParameterPage("Sequencer", "Play");
    }
    sr.writePin(SEQ_PLAY_LED, HIGH);
    sr.writePin(SEQ_STOP_LED, LOW);
    seqStopSW = 0;
    midi6CCOut(MIDIseqPlaySW, 127);
  }
}

void updateseqStopSW() {
  if (seqStopSW) {
    if (!recallPatchFlag) {
      showCurrentParameterPage("Sequencer", "Stop");
    }
    sr.writePin(SEQ_PLAY_LED, LOW);
    sr.writePin(SEQ_STOP_LED, HIGH);
    seqPlaySW = 0;
    midi6CCOut(MIDIseqStopSW, 127);
  }
}

void updateseqKeySW() {
  if (seqKeySW) {
    if (!recallPatchFlag) {
      showCurrentParameterPage("Sequencer", "Key Start On");
    }
    sr.writePin(SEQ_KEY_LED, HIGH);
    midi6CCOut(MIDIseqKeySW, 127);
  }
  if (!seqKeySW) {
    if (!recallPatchFlag) {
      showCurrentParameterPage("Sequencer", "Key Start Off");

      sr.writePin(SEQ_KEY_LED, LOW);
      midi6CCOut(MIDIseqKeySW, 127);
    }
  }
}

void updateseqTransSW() {
  if (seqTransSW) {
    if (!recallPatchFlag) {
      showCurrentParameterPage("Sequencer", "Transpose On");
    }
    sr.writePin(SEQ_TRANS_LED, HIGH);
    midi6CCOut(MIDIseqTransSW, 127);
  }
  if (!seqTransSW) {
    if (!recallPatchFlag) {
      showCurrentParameterPage("Sequencer", "Transpose Off");

      sr.writePin(SEQ_TRANS_LED, LOW);
      midi6CCOut(MIDIseqTransSW, 127);
    }
  }
}

void updateseqLoopSW() {
  if (seqLoopSW) {
    if (!recallPatchFlag) {
      showCurrentParameterPage("Sequencer", "Loop On");
    }
    sr.writePin(SEQ_LOOP_LED, HIGH);
    midi6CCOut(MIDIseqLoopSW, 127);
  }
  if (!seqLoopSW) {
    if (!recallPatchFlag) {
      showCurrentParameterPage("Sequencer", "Loop Off");

      sr.writePin(SEQ_LOOP_LED, LOW);
      midi6CCOut(MIDIseqLoopSW, 127);
    }
  }
}

void updateseqFwSW() {
  if (seqFwSW) {
    if (!recallPatchFlag) {
      showCurrentParameterPage("Sequencer", "FF");
    }
    midi6CCOut(MIDIseqFwSW, 127);
  }
}

void updateseqBwSW() {
  if (seqBwSW) {
    if (!recallPatchFlag) {
      showCurrentParameterPage("Sequencer", "Rew");
    }
    midi6CCOut(MIDIseqBwSW, 127);
  }
}

void updateseqEnable1SW() {
  if (seqEnable1SW) {
    if (!recallPatchFlag) {
      showCurrentParameterPage("Sequencer", " Track 1");
    }
    sr.writePin(SEQ_ENABLE_1_LED, HIGH);
    midi6CCOut(MIDIseqEnable1SW, 127);
  }
  if (!seqEnable1SW) {
    if (!recallPatchFlag) {
      showCurrentParameterPage("Sequencer", "Track 1 Off");
      sr.writePin(SEQ_ENABLE_1_LED, LOW);
      midi6CCOut(MIDIseqEnable1SW, 127);
    }
  }
}

void updateseqEnable2SW() {
  if (seqEnable2SW) {
    if (!recallPatchFlag) {
      showCurrentParameterPage("Sequencer", " Track 2");
    }
    sr.writePin(SEQ_ENABLE_2_LED, HIGH);
    midi6CCOut(MIDIseqEnable2SW, 127);
  }
  if (!seqEnable2SW) {
    if (!recallPatchFlag) {
      showCurrentParameterPage("Sequencer", "Track 2 Off");
      sr.writePin(SEQ_ENABLE_2_LED, LOW);
      midi6CCOut(MIDIseqEnable2SW, 127);
    }
  }
}

void updateseqEnable3SW() {
  if (seqEnable3SW) {
    if (!recallPatchFlag) {
      showCurrentParameterPage("Sequencer", " Track 3");
    }
    sr.writePin(SEQ_ENABLE_3_LED, HIGH);
    midi6CCOut(MIDIseqEnable3SW, 127);
  }
  if (!seqEnable3SW) {
    if (!recallPatchFlag) {
      showCurrentParameterPage("Sequencer", "Track 3 Off");
      sr.writePin(SEQ_ENABLE_3_LED, LOW);
      midi6CCOut(MIDIseqEnable3SW, 127);
    }
  }
}

void updateseqEnable4SW() {
  if (seqEnable4SW) {
    if (!recallPatchFlag) {
      showCurrentParameterPage("Sequencer", " Track 4");
    }
    sr.writePin(SEQ_ENABLE_4_LED, HIGH);
    midi6CCOut(MIDIseqEnable4SW, 127);
  }
  if (!seqEnable4SW) {
    if (!recallPatchFlag) {
      showCurrentParameterPage("Sequencer", "Track 4 Off");
      sr.writePin(SEQ_ENABLE_4_LED, LOW);
      midi6CCOut(MIDIseqEnable4SW, 127);
    }
  }
}

void updateseqSyncSW() {
  if (seqSyncSW) {
    if (!recallPatchFlag) {
      showCurrentParameterPage("Sequencer", " Sync On");
    }
    sr.writePin(SEQ_SYNC_LED, HIGH);
    midi6CCOut(MIDIseqSyncSW, 127);
  }
  if (!seqSyncSW) {
    if (!recallPatchFlag) {
      showCurrentParameterPage("Sequencer", "Sync Off");
      sr.writePin(SEQ_SYNC_LED, LOW);
      midi6CCOut(MIDIseqSyncSW, 127);
    }
  }
}

void updateseqrecEditSW() {
  if (seqrecEditSW) {
    if (!recallPatchFlag) {
      showCurrentParameterPage("Sequencer", " Rec/Edit On");
    }
    sr.writePin(SEQ_REC_EDIT_LED, HIGH);
    midi6CCOut(MIDIseqrecEditSW, 127);
  }
  if (!seqrecEditSW) {
    if (!recallPatchFlag) {
      showCurrentParameterPage("Sequencer", "Rec/Edit Off");
    }
    sr.writePin(SEQ_REC_EDIT_LED, LOW);
    midi6CCOut(MIDIseqrecEditSW, 127);
  }
}

void updateseqinsStepSW() {
  if (seqinsStepSW) {
    if (!recallPatchFlag) {
      showCurrentParameterPage("Sequencer", "Insert Step");
    }
    midi6CCOut(MIDIseqinsStepSW, 127);
  }
}

void updateseqdelStepSW() {
  if (seqdelStepSW) {
    if (!recallPatchFlag) {
      showCurrentParameterPage("Sequencer", "Delete Step");
    }
    midi6CCOut(MIDIseqdelStepSW, 127);
  }
}

void updateseqaddStepSW() {
  if (seqaddStepSW) {
    if (!recallPatchFlag) {
      showCurrentParameterPage("Sequencer", "Add Step");
    }
    midi6CCOut(MIDIseqaddStepSW, 127);
  }
}

void updateseqRestSW() {
  if (seqRestSW) {
    if (!recallPatchFlag) {
      showCurrentParameterPage("Sequencer", "Insert Rest");
    }
    midi6CCOut(MIDIseqRestSW, 127);
  }
}

void updateseqUtilSW() {
  if (seqUtilSW) {
    if (!recallPatchFlag) {
      showCurrentParameterPage("Sequencer", "Utilities");
    }
    midi6CCOut(MIDIseqUtilSW, 127);
  }
}

void updateUtilitySW() {
  switch (utilitySW) {
    case 1:
      showCurrentParameterPage("Swap Layers", "Upper - Lower");
      oldutilitySW = utilitySW;
      break;

    case 2:
      showCurrentParameterPage("Copy Upper", "to Lower");
      oldutilitySW = utilitySW;
      break;

    case 3:
      showCurrentParameterPage("Copy Lower", "to Upper");
      oldutilitySW = utilitySW;
      break;

    case 4:
      showCurrentParameterPage("Reset Upper", "to Defaults");
      oldutilitySW = utilitySW;
      break;

    case 5:
      showCurrentParameterPage("Reset Lower", "to Defaults");
      oldutilitySW = utilitySW;
      break;

    case 6:
      showCurrentParameterPage("Copy FX Upper", "to Lower FX");
      oldutilitySW = utilitySW;
      break;

    default:
      showCurrentParameterPage("Copy FX Lower", "to Upper FX");
      oldutilitySW = 0;
      break;
  }
}

void swap(int &lowerVal, int &upperVal) {
  temp = lowerVal;
  lowerVal = upperVal;
  upperVal = temp;
}

void updateUtilityAction() {
  switch (utilitySW) {
    case 1:
      //Serial.println("1");
      recallPatchFlag = true;
      MIDI.sendProgramChange(0, midiOutCh);
      delay(20);

      swap(layerPanU, layerPanL);
      swap(layerVolumeU, layerVolumeL);
      swap(arpFrequencyU, arpFrequencyL);
      swap(ampVelocityU, ampVelocityL);
      swap(filterVelocityU, filterVelocityL);

      swap(ampReleaseL, ampReleaseU);
      swap(ampSustainL, ampSustainU);
      swap(ampDecayL, ampDecayU);
      swap(ampAttackL, ampAttackU);
      swap(filterKeyboardL, filterKeyboardU);
      swap(filterResonanceL, filterResonanceU);
      swap(osc2VolumeL, osc2VolumeU);
      swap(osc2PWL, osc2PWU);
      swap(osc1PWL, osc1PWU);
      swap(osc1VolumeL, osc1VolumeU);
      swap(filterCutoffL, filterCutoffU);
      swap(filterEnvAmountL, filterEnvAmountU);
      swap(filterAttackL, filterAttackU);
      swap(filterDecayL, filterDecayU);
      swap(filterSustainL, filterSustainU);
      swap(filterReleaseL, filterReleaseU);
      swap(unisonDetuneL, unisonDetuneU);
      swap(glideSpeedL, glideSpeedU);
      swap(osc1TransposeL, osc1TransposeU);
      swap(osc2TransposeL, osc2TransposeU);
      swap(noiseLevelL, noiseLevelU);
      swap(glideAmountL, glideAmountU);
      swap(osc1TuneL, osc1TuneU);
      swap(osc2TuneL, osc2TuneU);
      swap(lfo1FrequencyL, lfo1FrequencyU);
      swap(lfo1DepthAL, lfo1DepthAU);
      swap(lfo1DepthBL, lfo1DepthBU);
      swap(lfo1DelayL, lfo1DelayU);
      swap(arpRange4SWL, arpRange4SWU);
      swap(arpRange3SWL, arpRange3SWU);
      swap(arpRange2SWL, arpRange2SWU);
      swap(arpRange1SWL, arpRange1SWU);
      swap(arpSyncSWL, arpSyncSWU);
      swap(arpHoldSWL, arpHoldSWU);
      swap(arpRandSWL, arpRandSWU);
      swap(arpUpDownSWL, arpUpDownSWU);
      swap(arpDownSWL, arpDownSWU);
      swap(arpUpSWL, arpUpSWU);
      swap(arpOffSWL, arpOffSWU);
      swap(envInvSWL, envInvSWU);
      swap(filterHPSWL, filterHPSWU);
      swap(filterBP2SWL, filterBP2SWU);
      swap(filterBP1SWL, filterBP1SWU);
      swap(filterLP2SWL, filterLP2SWU);
      swap(filterLP1SWL, filterLP1SWU);
      swap(noisePinkSWL, noisePinkSWU);
      swap(noiseWhiteSWL, noiseWhiteSWU);
      swap(noiseOffSWL, noiseOffSWU);
      swap(osc1ringModSWL, osc1ringModSWU);
      swap(osc2ringModSWL, osc2ringModSWU);
      swap(osc1_osc2PWMSWL, osc1_osc2PWMSWU);
      swap(osc1squareSWL, osc1squareSWU);
      swap(osc1pulseSWL, osc1pulseSWU);
      swap(osc1squareSWL, osc1squareSWU);
      swap(osc1sawSWL, osc1sawSWU);
      swap(osc1triangleSWL, osc1triangleSWU);
      swap(osc2_osc1PWMSWL, osc2_osc1PWMSWU);
      swap(osc2pulseSWL, osc2pulseSWU);
      swap(osc2squareSWL, osc2squareSWU);
      swap(osc2sawSWL, osc2sawSWU);
      swap(osc2triangleSWL, osc2triangleSWU);
      swap(osc1_1SWL, osc1_1SWU);
      swap(osc1_2SWL, osc1_2SWU);
      swap(osc1_4SWL, osc1_4SWU);
      swap(osc1_8SWL, osc1_8SWU);
      swap(osc1_16SWL, osc1_16SWU);
      swap(osc2_1SWL, osc2_1SWU);
      swap(osc2_2SWL, osc2_2SWU);
      swap(osc2_4SWL, osc2_4SWU);
      swap(osc2_8SWL, osc2_8SWU);
      swap(osc2_16SWL, osc2_16SWU);
      swap(osc1glideSWL, osc1glideSWU);
      swap(osc2glideSWL, osc2glideSWU);
      swap(portSWL, portSWU);
      swap(glideSWL, glideSWU);
      swap(glideOffSWL, glideOffSWU);
      swap(osc2SyncSWL, osc2SyncSWU);
      swap(multiTriggerSWL, multiTriggerSWU);
      swap(polySWL, polySWU);
      swap(singleMonoSWL, singleMonoSWU);
      swap(unisonMonoSWL, unisonMonoSWU);
      swap(lfo1SyncSWL, lfo1SyncSWU);
      swap(lfo1modWheelSWL, lfo1modWheelSWU);
      swap(lfo1randSWL, lfo1randSWU);
      swap(lfo1resetSWL, lfo1resetSWU);
      swap(lfo1osc1SWL, lfo1osc1SWU);
      swap(lfo1osc2SWL, lfo1osc2SWU);
      swap(lfo1pw1SWL, lfo1pw1SWU);
      swap(lfo1pw2SWL, lfo1pw2SWU);
      swap(lfo1filtSWL, lfo1filtSWU);
      swap(lfo1ampSWL, lfo1ampSWU);
      swap(lfo1seqRateSWL, lfo1seqRateSWU);
      swap(lfo1squareUniSWL, lfo1squareUniSWU);
      swap(lfo1squareBipSWL, lfo1squareBipSWU);
      swap(lfo1sawUpSWL, lfo1sawUpSWU);
      swap(lfo1sawDnSWL, lfo1sawDnSWU);
      swap(lfo1triangleSWL, lfo1triangleSWU);

      // effects

      swap(reverbLevelL, reverbLevelU);
      swap(reverbDecayL, reverbDecayU);
      swap(reverbEQL, reverbEQU);
      swap(revGLTCSWL, revGLTCSWU);
      swap(revHallSWL, revHallSWU);
      swap(revPlateSWL, revPlateSWU);
      swap(revRoomSWL, revRoomSWU);
      swap(revOffSWL, revOffSWU);

      swap(echoEQL, echoEQU);
      swap(echoLevelL, echoLevelU);
      swap(echoFeedbackL, echoFeedbackU);
      swap(echoSpreadL, echoSpreadU);
      swap(echoTimeL, echoTimeU);
      swap(echoSyncSWL, echoSyncSWU);
      swap(echoPingPongSWL, echoPingPongSWU);
      swap(echoTapeSWL, echoTapeSWU);
      swap(echoSTDSWL, echoSTDSWU);
      swap(echoOffSWL, echoOffSWU);

      swap(chorus3SWL, chorus3SWU);
      swap(chorus2SWL, chorus2SWU);
      swap(chorus1SWL, chorus1SWU);
      swap(chorusOffSWL, chorusOffSWU);

      updateEverything();

      showCurrentParameterPage("Layer Swap", "Completed");
      recallPatchFlag = false;
      break;

    case 2:
      //Serial.println("2");
      recallPatchFlag = true;
      MIDI.sendProgramChange(0, midiOutCh);
      delay(20);

      layerPanL = layerPanU;
      layerVolumeL = layerVolumeU;
      arpFrequencyL = arpFrequencyU;
      ampVelocityL = ampVelocityU;
      filterVelocityL = filterVelocityU;
      ampReleaseL = ampReleaseU;
      ampSustainL = ampSustainU;
      ampDecayL = ampDecayU;
      ampAttackL = ampAttackU;
      filterKeyboardL = filterKeyboardU;
      filterResonanceL = filterResonanceU;
      osc2VolumeL = osc2VolumeU;
      osc2PWL = osc2PWU;
      osc1PWL = osc1PWU;
      osc1VolumeL = osc1VolumeU;
      filterCutoffL = filterCutoffU;
      filterEnvAmountL = filterEnvAmountU;
      filterAttackL = filterAttackU;
      filterDecayL = filterDecayU;
      filterSustainL = filterSustainU;
      filterReleaseL = filterReleaseU;
      unisonDetuneL = unisonDetuneU;
      glideSpeedL = glideSpeedU;
      osc1TransposeL = osc1TransposeU;
      osc2TransposeL = osc2TransposeU;
      noiseLevelL = noiseLevelU;
      glideAmountL = glideAmountU;
      osc1TuneL = osc1TuneU;
      osc2TuneL = osc2TuneU;
      lfo1FrequencyL = lfo1FrequencyU;
      lfo1DepthAL = lfo1DepthAU;
      lfo1DepthBL = lfo1DepthBU;
      lfo1DelayL = lfo1DelayU;
      arpRange4SWL = arpRange4SWU;
      arpRange3SWL = arpRange3SWU;
      arpRange2SWL = arpRange2SWU;
      arpRange1SWL = arpRange1SWU;
      arpSyncSWL = arpSyncSWU;
      arpHoldSWL = arpHoldSWU;
      arpRandSWL = arpRandSWU;
      arpUpDownSWL = arpUpDownSWU;
      arpDownSWL = arpDownSWU;
      arpUpSWL = arpUpSWU;
      arpOffSWL = arpOffSWU;
      envInvSWL = envInvSWU;
      filterHPSWL = filterHPSWU;
      filterBP2SWL = filterBP2SWU;
      filterBP1SWL = filterBP1SWU;
      filterLP2SWL = filterLP2SWU;
      filterLP1SWL = filterLP1SWU;
      noisePinkSWL = noisePinkSWU;
      noiseWhiteSWL = noiseWhiteSWU;
      noiseOffSWL = noiseOffSWU;
      osc1ringModSWL = osc1ringModSWU;
      osc2ringModSWL = osc2ringModSWU;
      osc1_osc2PWMSWL = osc1_osc2PWMSWU;
      osc1pulseSWL = osc1pulseSWU;
      osc1squareSWL = osc1squareSWU;
      osc1sawSWL = osc1sawSWU;
      osc1triangleSWL = osc1triangleSWU;
      osc2_osc1PWMSWL = osc2_osc1PWMSWU;
      osc2pulseSWL = osc2pulseSWU;
      osc2squareSWL = osc2squareSWU;
      osc2sawSWL = osc2sawSWU;
      osc2triangleSWL = osc2triangleSWU;
      osc1_1SWL = osc1_1SWU;
      osc1_2SWL = osc1_2SWU;
      osc1_4SWL = osc1_4SWU;
      osc1_8SWL = osc1_8SWU;
      osc1_16SWL = osc1_16SWU;
      osc2_1SWL = osc2_1SWU;
      osc2_2SWL = osc2_2SWU;
      osc2_4SWL = osc2_4SWU;
      osc2_8SWL = osc2_8SWU;
      osc2_16SWL = osc2_16SWU;
      osc1glideSWL = osc1glideSWU;
      osc2glideSWL = osc2glideSWU;
      portSWL = portSWU;
      glideSWL = glideSWU;
      glideOffSWL = glideOffSWU;
      osc2SyncSWL = osc2SyncSWU;
      multiTriggerSWL = multiTriggerSWU;
      polySWL = polySWU;
      singleMonoSWL = singleMonoSWU;
      unisonMonoSWL = unisonMonoSWU;
      lfo1SyncSWL = lfo1SyncSWU;
      lfo1modWheelSWL = lfo1modWheelSWU;
      lfo1randSWL = lfo1randSWU;
      lfo1resetSWL = lfo1resetSWU;
      lfo1osc1SWL = lfo1osc1SWU;
      lfo1osc2SWL = lfo1osc2SWU;
      lfo1pw1SWL = lfo1pw1SWU;
      lfo1pw2SWL = lfo1pw2SWU;
      lfo1filtSWL = lfo1filtSWU;
      lfo1ampSWL = lfo1ampSWU;
      lfo1seqRateSWL = lfo1seqRateSWU;
      lfo1squareUniSWL = lfo1squareUniSWU;
      lfo1squareBipSWL = lfo1squareBipSWU;
      lfo1sawUpSWL = lfo1sawUpSWU;
      lfo1sawDnSWL = lfo1sawDnSWU;
      lfo1triangleSWL = lfo1triangleSWU;

      // effects

      reverbLevelL = reverbLevelU;
      reverbDecayL = reverbDecayU;
      reverbEQL = reverbEQU;
      revGLTCSWL = revGLTCSWU;
      revHallSWL = revHallSWU;
      revPlateSWL = revPlateSWU;
      revRoomSWL = revRoomSWU;
      revOffSWL = revOffSWU;

      echoEQL = echoEQU;
      echoLevelL = echoLevelU;
      echoFeedbackL = echoFeedbackU;
      echoSpreadL = echoSpreadU;
      echoTimeL = echoTimeU;
      echoSyncSWL = echoSyncSWU;
      echoPingPongSWL = echoPingPongSWU;
      echoTapeSWL = echoTapeSWU;
      echoSTDSWL = echoSTDSWU;
      echoOffSWL = echoOffSWU;

      chorus3SWL = chorus3SWU;
      chorus2SWL = chorus2SWU;
      chorus1SWL = chorus1SWU;
      chorusOffSWL = chorusOffSWU;

      updateEverything();

      showCurrentParameterPage("Copy to Lower", "Completed");
      recallPatchFlag = false;
      break;

    case 3:
      //Serial.println("3");
      recallPatchFlag = true;
      MIDI.sendProgramChange(0, midiOutCh);
      delay(20);
      layerPanU = layerPanL;
      layerVolumeU = layerVolumeL;
      arpFrequencyU = arpFrequencyL;
      ampVelocityU = ampVelocityL;
      filterVelocityU = filterVelocityL;
      ampReleaseU = ampReleaseL;
      ampSustainU = ampSustainL;
      ampDecayU = ampDecayL;
      ampAttackU = ampAttackL;
      filterKeyboardU = filterKeyboardL;
      filterResonanceU = filterResonanceL;
      osc2VolumeU = osc2VolumeL;
      osc2PWU = osc2PWL;
      osc1PWU = osc1PWL;
      osc1VolumeU = osc1VolumeL;
      filterCutoffU = filterCutoffL;
      filterEnvAmountU = filterEnvAmountL;
      filterAttackU = filterAttackL;
      filterDecayU = filterDecayL;
      filterSustainU = filterSustainL;
      filterReleaseU = filterReleaseL;
      unisonDetuneU = unisonDetuneL;
      glideSpeedU = glideSpeedL;
      osc1TransposeU = osc1TransposeL;
      osc2TransposeU = osc2TransposeL;
      noiseLevelU = noiseLevelL;
      glideAmountU = glideAmountL;
      osc1TuneU = osc1TuneL;
      osc2TuneU = osc2TuneL;
      lfo1FrequencyU = lfo1FrequencyL;
      lfo1DepthAU = lfo1DepthAL;
      lfo1DepthBU = lfo1DepthBL;
      lfo1DelayU = lfo1DelayL;
      arpRange4SWU = arpRange4SWL;
      arpRange3SWU = arpRange3SWL;
      arpRange2SWU = arpRange2SWL;
      arpRange1SWU = arpRange1SWL;
      arpSyncSWU = arpSyncSWL;
      arpHoldSWU = arpHoldSWL;
      arpRandSWU = arpRandSWL;
      arpUpDownSWU = arpUpDownSWL;
      arpDownSWU = arpDownSWL;
      arpUpSWU = arpUpSWL;
      arpOffSWU = arpOffSWL;
      envInvSWU = envInvSWL;
      filterHPSWU = filterHPSWL;
      filterBP2SWU = filterBP2SWL;
      filterBP1SWU = filterBP1SWL;
      filterLP2SWU = filterLP2SWL;
      filterLP1SWU = filterLP1SWL;
      noisePinkSWU = noisePinkSWL;
      noiseWhiteSWU = noiseWhiteSWL;
      noiseOffSWU = noiseOffSWL;
      osc1ringModSWU = osc1ringModSWL;
      osc2ringModSWU = osc2ringModSWL;
      osc1_osc2PWMSWU = osc1_osc2PWMSWL;
      osc1pulseSWU = osc1pulseSWL;
      osc1squareSWU = osc1squareSWL;
      osc1sawSWU = osc1sawSWL;
      osc1triangleSWU = osc1triangleSWL;
      osc2_osc1PWMSWU = osc2_osc1PWMSWL;
      osc2pulseSWU = osc2pulseSWL;
      osc2squareSWU = osc2squareSWL;
      osc2sawSWU = osc2sawSWL;
      osc2triangleSWU = osc2triangleSWL;
      osc1_1SWU = osc1_1SWL;
      osc1_2SWU = osc1_2SWL;
      osc1_4SWU = osc1_4SWL;
      osc1_8SWU = osc1_8SWL;
      osc1_16SWU = osc1_16SWL;
      osc2_1SWU = osc2_1SWL;
      osc2_2SWU = osc2_2SWL;
      osc2_4SWU = osc2_4SWL;
      osc2_8SWU = osc2_8SWL;
      osc2_16SWU = osc2_16SWL;
      osc1glideSWU = osc1glideSWL;
      osc2glideSWU = osc2glideSWL;
      portSWU = portSWL;
      glideSWU = glideSWL;
      glideOffSWU = glideOffSWL;
      osc2SyncSWU = osc2SyncSWL;
      multiTriggerSWU = multiTriggerSWL;
      polySWU = polySWL;
      singleMonoSWU = singleMonoSWL;
      unisonMonoSWU = unisonMonoSWL;
      lfo1SyncSWU = lfo1SyncSWL;
      lfo1modWheelSWU = lfo1modWheelSWL;
      lfo1randSWU = lfo1randSWL;
      lfo1resetSWU = lfo1resetSWL;
      lfo1osc1SWU = lfo1osc1SWL;
      lfo1osc2SWU = lfo1osc2SWL;
      lfo1pw1SWU = lfo1pw1SWL;
      lfo1pw2SWU = lfo1pw2SWL;
      lfo1filtSWU = lfo1filtSWL;
      lfo1ampSWU = lfo1ampSWL;
      lfo1seqRateSWU = lfo1seqRateSWL;
      lfo1squareUniSWU = lfo1squareUniSWL;
      lfo1squareBipSWU = lfo1squareBipSWL;
      lfo1sawUpSWU = lfo1sawUpSWL;
      lfo1sawDnSWU = lfo1sawDnSWL;
      lfo1triangleSWU = lfo1triangleSWL;

      reverbLevelU = reverbLevelL;
      reverbDecayU = reverbDecayL;
      reverbEQU = reverbEQL;
      revGLTCSWU = revGLTCSWL;
      revHallSWU = revHallSWL;
      revPlateSWU = revPlateSWL;
      revRoomSWU = revRoomSWL;
      revOffSWU = revOffSWL;

      echoEQU = echoEQL;
      echoLevelU = echoLevelL;
      echoFeedbackU = echoFeedbackL;
      echoSpreadU = echoSpreadL;
      echoTimeU = echoTimeL;
      echoSyncSWU = echoSyncSWL;
      echoPingPongSWU = echoPingPongSWL;
      ;
      echoTapeSWU = echoTapeSWL;
      echoSTDSWU = echoSTDSWL;
      echoOffSWU = echoOffSWL;

      chorus3SWU = chorus3SWL;
      chorus2SWU = chorus2SWL;
      chorus1SWU = chorus1SWL;
      chorusOffSWU = chorusOffSWL;

      updateEverything();

      showCurrentParameterPage("Copy to Upper", "Completed");
      recallPatchFlag = false;
      break;

    case 4:
      //Serial.println("4");
      recallPatchFlag = true;
      MIDI.sendProgramChange(0, midiOutCh);
      delay(20);

      layerPanU = 63;
      layerVolumeU = 63;
      arpFrequencyU = 60;
      ampVelocityU = 0;
      filterVelocityU = 0;
      ampReleaseU = 55;
      ampSustainU = 127;
      ampDecayU = 55;
      ampAttackU = 0;
      filterKeyboardU = 127;
      filterResonanceU = 0;
      osc2VolumeU = 77;
      osc2PWU = 63;
      osc1PWU = 63;
      osc1VolumeU = 77;
      filterCutoffU = 127;
      filterEnvAmountU = 0;
      filterAttackU = 0;
      filterDecayU = 55;
      filterSustainU = 127;
      filterReleaseU = 55;
      unisonDetuneU = 22;
      glideSpeedU = 37;
      osc1TransposeU = 0;
      osc2TransposeU = 0;
      noiseLevelU = 0;
      glideAmountU = 55;
      osc1TuneU = 63;
      osc2TuneU = 63;
      lfo1FrequencyU = 82;
      lfo1DepthAU = 0;
      lfo1DepthBU = 0;
      lfo1DelayU = 0;
      arpRange4SWU = 0;
      arpRange3SWU = 0;
      arpRange2SWU = 1;
      arpRange1SWU = 0;
      arpSyncSWU = 0;
      arpHoldSWU = 0;
      arpRandSWU = 0;
      arpUpDownSWU = 0;
      arpDownSWU = 0;
      arpUpSWU = 0;
      arpOffSWU = 1;
      envInvSWU = 0;
      filterHPSWU = 0;
      filterBP2SWU = 0;
      filterBP1SWU = 0;
      filterLP2SWU = 0;
      filterLP1SWU = 1;
      noisePinkSWU = 0;
      noiseWhiteSWU = 1;
      noiseOffSWU = 0;
      osc1ringModSWU = 0;
      osc2ringModSWU = 0;
      osc1_osc2PWMSWU = 0;
      osc1pulseSWU = 0;
      osc1squareSWU = 0;
      osc1sawSWU = 1;
      osc1triangleSWU = 0;
      osc2_osc1PWMSWU = 0;
      osc2pulseSWU = 0;
      osc2squareSWU = 0;
      osc2sawSWU = 1;
      osc2triangleSWU = 0;
      osc1_1SWU = 0;
      osc1_2SWU = 0;
      osc1_4SWU = 0;
      osc1_8SWU = 1;
      osc1_16SWU = 0;
      osc2_1SWU = 0;
      osc2_2SWU = 0;
      osc2_4SWU = 0;
      osc2_8SWU = 1;
      osc2_16SWU = 0;
      osc1glideSWU = 1;
      osc2glideSWU = 1;
      portSWU = 0;
      glideSWU = 0;
      glideOffSWU = 1;
      osc2SyncSWU = 0;
      multiTriggerSWU = 1;
      polySWU = 1;
      singleMonoSWU = 0;
      unisonMonoSWU = 0;
      lfo1SyncSWU = 0;
      lfo1modWheelSWU = 0;
      lfo1resetSWU = 0;
      lfo1osc1SWU = 1;
      lfo1osc2SWU = 1;
      lfo1pw1SWU = 0;
      lfo1pw2SWU = 0;
      lfo1filtSWU = 1;
      lfo1ampSWU = 0;
      lfo1seqRateSWU = 0;
      lfo1randSWU = 0;
      lfo1squareUniSWU = 0;
      lfo1squareBipSWU = 0;
      lfo1sawUpSWU = 0;
      ;
      lfo1sawDnSWU = 0;
      lfo1triangleSWU = 1;

      reverbLevelU = 63;
      reverbDecayU = 63;
      reverbEQU = 63;
      revGLTCSWU = 0;
      revHallSWU = 0;
      revPlateSWU = 0;
      revRoomSWU = 0;
      revOffSWU = 1;

      echoEQU = 63;
      echoLevelU = 63;
      echoFeedbackU = 22;
      echoSpreadU = 48;
      echoTimeU = 63;
      echoSyncSWU = 0;
      echoPingPongSWU = 0;
      echoTapeSWU = 0;
      echoSTDSWU = 0;
      echoOffSWU = 1;

      chorus3SWU = 0;
      chorus2SWU = 0;
      chorus1SWU = 0;
      chorusOffSWU = 1;

      updateEverything();

      showCurrentParameterPage("Reset Upper", "Completed");
      recallPatchFlag = false;
      break;

    case 5:
      //Serial.println("5");
      recallPatchFlag = true;
      MIDI.sendProgramChange(0, midiOutCh);
      delay(20);

      layerPanL = 63;
      layerVolumeL = 63;
      arpFrequencyL = 60;
      ampVelocityL = 0;
      filterVelocityL = 0;
      ampReleaseL = 55;
      ampSustainL = 127;
      ampDecayL = 55;
      ampAttackL = 0;
      filterKeyboardL = 127;
      filterResonanceL = 0;
      osc2VolumeL = 80;
      osc2PWL = 63;
      osc1PWL = 63;
      osc1VolumeL = 80;
      filterCutoffL = 127;
      filterEnvAmountL = 0;
      filterAttackL = 0;
      filterDecayL = 55;
      filterSustainL = 127;
      filterReleaseL = 55;
      unisonDetuneL = 22;
      glideSpeedL = 37;
      osc1TransposeL = 0;
      osc2TransposeL = 0;
      noiseLevelL = 0;
      glideAmountL = 55;
      osc1TuneL = 63;
      osc2TuneL = 63;
      lfo1FrequencyL = 75;
      lfo1DepthAL = 0;
      lfo1DepthBL = 0;
      lfo1DelayL = 0;
      arpRange4SWL = 0;
      arpRange3SWL = 0;
      arpRange2SWL = 1;
      arpRange1SWL = 0;
      arpSyncSWL = 0;
      arpHoldSWL = 0;
      arpRandSWL = 0;
      arpUpDownSWL = 0;
      arpDownSWL = 0;
      arpUpSWL = 0;
      arpOffSWL = 1;
      envInvSWL = 0;
      filterHPSWL = 0;
      filterBP2SWL = 0;
      filterBP1SWL = 0;
      filterLP2SWL = 0;
      filterLP1SWL = 1;
      noisePinkSWL = 0;
      noiseWhiteSWL = 1;
      noiseOffSWL = 0;
      osc1ringModSWL = 0;
      osc2ringModSWL = 0;
      osc1_osc2PWMSWL = 0;
      osc1pulseSWL = 0;
      osc1squareSWL = 0;
      osc1sawSWL = 1;
      osc1triangleSWL = 0;
      osc2_osc1PWMSWL = 0;
      osc2pulseSWL = 0;
      osc2squareSWL = 0;
      osc2sawSWL = 1;
      osc2triangleSWL = 0;
      osc1_1SWL = 0;
      osc1_2SWL = 0;
      osc1_4SWL = 0;
      osc1_8SWL = 1;
      osc1_16SWL = 0;
      osc2_1SWL = 0;
      osc2_2SWL = 0;
      osc2_4SWL = 0;
      osc2_8SWL = 1;
      osc2_16SWL = 0;
      osc1glideSWL = 1;
      osc2glideSWL = 1;
      portSWL = 0;
      glideSWL = 0;
      glideOffSWL = 1;
      osc2SyncSWL = 0;
      multiTriggerSWL = 1;
      polySWL = 1;
      singleMonoSWL = 0;
      unisonMonoSWL = 0;
      lfo1SyncSWL = 0;
      lfo1modWheelSWL = 0;
      lfo1resetSWL = 0;
      lfo1osc1SWL = 1;
      lfo1osc2SWL = 1;
      lfo1pw1SWL = 0;
      lfo1pw2SWL = 0;
      lfo1filtSWL = 1;
      lfo1ampSWL = 0;
      lfo1seqRateSWL = 0;
      lfo1randSWL = 0;
      lfo1squareUniSWL = 0;
      lfo1squareBipSWL = 0;
      lfo1sawUpSWL = 0;
      lfo1sawDnSWL = 0;
      lfo1triangleSWL = 1;

      // effects

      reverbLevelL = 63;
      reverbDecayL = 63;
      reverbEQL = 63;
      revGLTCSWL = 0;
      revHallSWL = 0;
      revPlateSWL = 0;
      revRoomSWL = 0;
      revOffSWL = 1;

      echoEQL = 63;
      echoLevelL = 63;
      echoFeedbackL = 22;
      echoSpreadL = 55;
      echoTimeL = 63;
      echoSyncSWL = 0;
      echoPingPongSWL = 0;
      echoTapeSWL = 0;
      echoSTDSWL = 0;
      echoOffSWL = 1;

      chorus3SWL = 0;
      chorus2SWL = 0;
      chorus1SWL = 0;
      chorusOffSWL = 1;

      updateEverything();

      showCurrentParameterPage("Reset Lower", "Completed");
      recallPatchFlag = false;
      break;

    case 6:
      //Serial.println("6");
      recallPatchFlag = true;
      MIDI.sendProgramChange(0, midiOutCh);
      delay(20);

      reverbLevelL = reverbLevelU;
      reverbDecayL = reverbDecayU;
      reverbEQL = reverbEQU;
      revGLTCSWL = revGLTCSWU;
      revHallSWL = revHallSWU;
      revPlateSWL = revPlateSWU;
      revRoomSWL = revRoomSWU;
      revOffSWL = revOffSWU;

      echoEQL = echoEQU;
      echoLevelL = echoLevelU;
      echoFeedbackL = echoFeedbackU;
      echoSpreadL = echoSpreadU;
      echoTimeL = echoTimeU;
      echoSyncSWL = echoSyncSWU;
      echoPingPongSWL = echoPingPongSWU;
      echoTapeSWL = echoTapeSWU;
      echoSTDSWL = echoSTDSWU;
      echoOffSWL = echoOffSWU;

      chorus3SWL = chorus3SWU;
      chorus2SWL = chorus2SWU;
      chorus1SWL = chorus1SWU;
      chorusOffSWL = chorusOffSWU;

      updateEverything();

      showCurrentParameterPage("Copy FX Upper", "Completed");
      recallPatchFlag = false;
      break;

    default:
      //Serial.println("Default");
      recallPatchFlag = true;
      MIDI.sendProgramChange(0, midiOutCh);
      delay(20);

      reverbLevelU = reverbLevelL;
      reverbDecayU = reverbDecayL;
      reverbEQU = reverbEQL;
      revGLTCSWU = revGLTCSWL;
      revHallSWU = revHallSWL;
      revPlateSWU = revPlateSWL;
      revRoomSWU = revRoomSWL;
      revOffSWU = revOffSWL;

      echoEQU = echoEQL;
      echoLevelU = echoLevelL;
      echoFeedbackU = echoFeedbackL;
      echoSpreadU = echoSpreadL;
      echoTimeU = echoTimeL;
      echoSyncSWU = echoSyncSWL;
      echoPingPongSWU = echoPingPongSWL;
      echoTapeSWU = echoTapeSWL;
      echoSTDSWU = echoSTDSWL;
      echoOffSWU = echoOffSWL;

      chorus3SWU = chorus3SWL;
      chorus2SWU = chorus2SWL;
      chorus1SWU = chorus1SWL;
      chorusOffSWU = chorusOffSWL;

      updateEverything();

      showCurrentParameterPage("Copy FX Lower", "Completed");
      recallPatchFlag = false;
      break;
  }
}

void updatearpRandSW() {
  if (!recallPatchFlag) {
    showCurrentParameterPage("ARP Random", "On");
  }
  if (arpRandSWL && lowerSW) {
    green.writePin(GREEN_ARP_RAND_LED, HIGH);
    green.writePin(GREEN_ARP_UP_DOWN_LED, LOW);
    green.writePin(GREEN_ARP_DOWN_LED, LOW);
    green.writePin(GREEN_ARP_UP_LED, LOW);
    sr.writePin(ARP_RAND_LED, LOW);
    sr.writePin(ARP_UP_DOWN_LED, LOW);
    sr.writePin(ARP_DOWN_LED, LOW);
    sr.writePin(ARP_UP_LED, LOW);
    arpUpDownSWL = 0;
    arpDownSWL = 0;
    arpUpSWL = 0;
    arpOffSWL = 0;
  }
  if (arpRandSWU && upperSW) {
    sr.writePin(ARP_RAND_LED, HIGH);
    sr.writePin(ARP_UP_DOWN_LED, LOW);
    sr.writePin(ARP_DOWN_LED, LOW);
    sr.writePin(ARP_UP_LED, LOW);
    green.writePin(GREEN_ARP_RAND_LED, LOW);
    green.writePin(GREEN_ARP_UP_DOWN_LED, LOW);
    green.writePin(GREEN_ARP_DOWN_LED, LOW);
    green.writePin(GREEN_ARP_UP_LED, LOW);
    arpUpDownSWU = 0;
    arpDownSWU = 0;
    arpUpSWU = 0;
    arpOffSWU = 0;
  }

  if (!layerPatchFlag) {
    if (upperSW && arpRandSWU) {
      midiCCOut(MIDIarpDirectionU, 65);
    }
    if (lowerSW && arpRandSWL) {
      midiCCOut(MIDIarpDirectionL, 65);
    }
  }
}

void updatearpUpDownSW() {
  if (!recallPatchFlag) {
    showCurrentParameterPage("ARP Up/Down", "On");
  }
  if (arpUpDownSWL && lowerSW) {
    green.writePin(GREEN_ARP_RAND_LED, LOW);
    green.writePin(GREEN_ARP_UP_DOWN_LED, HIGH);
    green.writePin(GREEN_ARP_DOWN_LED, LOW);
    green.writePin(GREEN_ARP_UP_LED, LOW);
    sr.writePin(ARP_RAND_LED, LOW);
    sr.writePin(ARP_UP_DOWN_LED, LOW);
    sr.writePin(ARP_DOWN_LED, LOW);
    sr.writePin(ARP_UP_LED, LOW);
    arpRandSWL = 0;
    arpDownSWL = 0;
    arpUpSWL = 0;
    arpOffSWL = 0;
  }
  if (arpUpDownSWU && upperSW) {
    sr.writePin(ARP_RAND_LED, LOW);
    sr.writePin(ARP_UP_DOWN_LED, HIGH);
    sr.writePin(ARP_DOWN_LED, LOW);
    sr.writePin(ARP_UP_LED, LOW);
    green.writePin(GREEN_ARP_RAND_LED, LOW);
    green.writePin(GREEN_ARP_UP_DOWN_LED, LOW);
    green.writePin(GREEN_ARP_DOWN_LED, LOW);
    green.writePin(GREEN_ARP_UP_LED, LOW);
    arpRandSWU = 0;
    arpDownSWU = 0;
    arpUpSWU = 0;
    arpOffSWU = 0;
  }

  if (!layerPatchFlag) {
    if (upperSW && arpUpDownSWU) {
      midiCCOut(MIDIarpDirectionU, 75);
    }
    if (lowerSW && arpUpDownSWL) {
      midiCCOut(MIDIarpDirectionL, 75);
    }
  }
}

void updatearpDownSW() {
  if (!recallPatchFlag) {
    showCurrentParameterPage("ARP Down", "On");
  }
  if (arpDownSWL && lowerSW) {
    green.writePin(GREEN_ARP_RAND_LED, LOW);
    green.writePin(GREEN_ARP_UP_DOWN_LED, LOW);
    green.writePin(GREEN_ARP_DOWN_LED, HIGH);
    green.writePin(GREEN_ARP_UP_LED, LOW);
    sr.writePin(ARP_RAND_LED, LOW);
    sr.writePin(ARP_UP_DOWN_LED, LOW);
    sr.writePin(ARP_DOWN_LED, LOW);
    sr.writePin(ARP_UP_LED, LOW);
    arpRandSWL = 0;
    arpUpDownSWL = 0;
    arpUpSWL = 0;
    arpOffSWL = 0;
  }
  if (arpDownSWU && upperSW) {
    sr.writePin(ARP_RAND_LED, LOW);
    sr.writePin(ARP_UP_DOWN_LED, LOW);
    sr.writePin(ARP_DOWN_LED, HIGH);
    sr.writePin(ARP_UP_LED, LOW);
    green.writePin(GREEN_ARP_RAND_LED, LOW);
    green.writePin(GREEN_ARP_UP_DOWN_LED, LOW);
    green.writePin(GREEN_ARP_DOWN_LED, LOW);
    green.writePin(GREEN_ARP_UP_LED, LOW);
    arpRandSWU = 0;
    arpUpDownSWU = 0;
    arpUpSWU = 0;
    arpOffSWU = 0;
  }

  if (!layerPatchFlag) {
    if (upperSW && arpDownSWU) {
      midiCCOut(MIDIarpDirectionU, 85);
    }
    if (lowerSW && arpDownSWL) {
      midiCCOut(MIDIarpDirectionL, 85);
    }
  }
}

void updatearpUpSW() {
  if (!recallPatchFlag) {
    showCurrentParameterPage("ARP Up", "On");
  }
  if (arpUpSWL && lowerSW) {
    green.writePin(GREEN_ARP_RAND_LED, LOW);
    green.writePin(GREEN_ARP_UP_DOWN_LED, LOW);
    green.writePin(GREEN_ARP_DOWN_LED, LOW);
    green.writePin(GREEN_ARP_UP_LED, HIGH);
    sr.writePin(ARP_RAND_LED, LOW);
    sr.writePin(ARP_UP_DOWN_LED, LOW);
    sr.writePin(ARP_DOWN_LED, LOW);
    sr.writePin(ARP_UP_LED, LOW);
    arpRandSWL = 0;
    arpDownSWL = 0;
    arpUpDownSWL = 0;
    arpOffSWU = 0;
  }
  if (arpUpSWU && upperSW) {
    sr.writePin(ARP_RAND_LED, LOW);
    sr.writePin(ARP_UP_DOWN_LED, LOW);
    sr.writePin(ARP_DOWN_LED, LOW);
    sr.writePin(ARP_UP_LED, HIGH);
    green.writePin(GREEN_ARP_RAND_LED, LOW);
    green.writePin(GREEN_ARP_UP_DOWN_LED, LOW);
    green.writePin(GREEN_ARP_DOWN_LED, LOW);
    green.writePin(GREEN_ARP_UP_LED, LOW);
    arpRandSWU = 0;
    arpDownSWU = 0;
    arpUpDownSWU = 0;
    arpOffSWU = 0;
  }

  if (!layerPatchFlag) {
    if (upperSW && arpUpSWU) {
      midiCCOut(MIDIarpDirectionU, 97);
    }
    if (lowerSW && arpUpSWL) {
      midiCCOut(MIDIarpDirectionL, 97);
    }
  }
}

void updatearpOffSW() {
  if (!recallPatchFlag) {
    showCurrentParameterPage("ARP", "Off");
  }
  if (arpOffSWL && lowerSW) {
    green.writePin(GREEN_ARP_RAND_LED, LOW);
    green.writePin(GREEN_ARP_UP_DOWN_LED, LOW);
    green.writePin(GREEN_ARP_DOWN_LED, LOW);
    green.writePin(GREEN_ARP_UP_LED, LOW);
    sr.writePin(ARP_RAND_LED, LOW);
    sr.writePin(ARP_UP_DOWN_LED, LOW);
    sr.writePin(ARP_DOWN_LED, LOW);
    sr.writePin(ARP_UP_LED, LOW);
    arpRandSWL = 0;
    arpDownSWL = 0;
    arpUpDownSWL = 0;
    arpUpSWL = 0;
  }
  if (arpOffSWU && upperSW) {
    sr.writePin(ARP_RAND_LED, LOW);
    sr.writePin(ARP_UP_DOWN_LED, LOW);
    sr.writePin(ARP_DOWN_LED, LOW);
    sr.writePin(ARP_UP_LED, LOW);
    green.writePin(GREEN_ARP_RAND_LED, LOW);
    green.writePin(GREEN_ARP_UP_DOWN_LED, LOW);
    green.writePin(GREEN_ARP_DOWN_LED, LOW);
    green.writePin(GREEN_ARP_UP_LED, LOW);
    arpRandSWU = 0;
    arpDownSWU = 0;
    arpUpDownSWU = 0;
    arpUpSWU = 0;
  }

  if (!layerPatchFlag) {
    if (upperSW && arpOffSWU) {
      midiCCOut(MIDIarpDirectionU, 120);
    }
    if (lowerSW && arpOffSWL) {
      midiCCOut(MIDIarpDirectionL, 120);
    }
  }
}

void updateenvInvSW() {

  if (envInvSWL && lowerSW) {
    green.writePin(GREEN_ENV_INV_LED, HIGH);
    sr.writePin(ENV_INV_LED, LOW);
    if (!recallPatchFlag) {
      showCurrentParameterPage("Env Invert", "Lower On");
    }
    if (!layerPatchFlag) {
      midiCCOut(MIDIenvInvL, 127);
    }
    envInvSW = 1;
  }
  if (!envInvSWL && lowerSW) {
    green.writePin(GREEN_ENV_INV_LED, LOW);
    sr.writePin(ENV_INV_LED, LOW);
    if (!recallPatchFlag) {
      showCurrentParameterPage("Env Invert", "Lower Off");
      if (!layerPatchFlag) {
        midiCCOut(MIDIenvInvL, 127);
      }
    }
    envInvSW = 0;
  }
  if (envInvSWU && upperSW) {
    sr.writePin(ENV_INV_LED, HIGH);
    green.writePin(GREEN_ENV_INV_LED, LOW);
    if (!recallPatchFlag) {
      showCurrentParameterPage("Env Invert", "Upper On");
    }
    if (!layerPatchFlag) {
      midiCCOut(MIDIenvInvU, 127);
    }
    envInvSW = 1;
  }
  if (!envInvSWU && upperSW) {
    sr.writePin(ENV_INV_LED, LOW);
    green.writePin(GREEN_ENV_INV_LED, LOW);
    if (!recallPatchFlag) {
      showCurrentParameterPage("Env Invert", "Upper Off");
      if (!layerPatchFlag) {
        midiCCOut(MIDIenvInvU, 127);
      }
    }
    envInvSW = 0;
  }
}

void updatefilterHPSW() {
  if (!recallPatchFlag) {
    showCurrentParameterPage("Filter HP", "On");
  }
  if (filterHPSWL && lowerSW) {
    green.writePin(GREEN_FILT_HP_LED, HIGH);
    green.writePin(GREEN_FILT_BP2_LED, LOW);
    green.writePin(GREEN_FILT_BP1_LED, LOW);
    green.writePin(GREEN_FILT_LP2_LED, LOW);
    green.writePin(GREEN_FILT_LP1_LED, LOW);
    sr.writePin(FILT_HP_LED, LOW);
    sr.writePin(FILT_BP2_LED, LOW);
    sr.writePin(FILT_BP1_LED, LOW);
    sr.writePin(FILT_LP2_LED, LOW);
    sr.writePin(FILT_LP1_LED, LOW);
    filterBP2SWL = 0;
    filterBP1SWL = 0;
    filterLP2SWL = 0;
    filterLP1SWL = 0;
  }
  if (filterHPSWU && upperSW) {
    sr.writePin(FILT_HP_LED, HIGH);
    sr.writePin(FILT_BP2_LED, LOW);
    sr.writePin(FILT_BP1_LED, LOW);
    sr.writePin(FILT_LP2_LED, LOW);
    sr.writePin(FILT_LP1_LED, LOW);
    green.writePin(GREEN_FILT_HP_LED, LOW);
    green.writePin(GREEN_FILT_BP2_LED, LOW);
    green.writePin(GREEN_FILT_BP1_LED, LOW);
    green.writePin(GREEN_FILT_LP2_LED, LOW);
    green.writePin(GREEN_FILT_LP1_LED, LOW);
    filterBP2SWU = 0;
    filterBP1SWU = 0;
    filterLP2SWU = 0;
    filterLP1SWU = 0;
  }

  if (!layerPatchFlag) {
    if (upperSW && filterHPSWU) {
      midiCCOut(MIDIfilterU, 65);
    }
    if (lowerSW && filterHPSWL) {
      midiCCOut(MIDIfilterL, 65);
    }
  }
}

void updatefilterBP2SW() {
  if (!recallPatchFlag) {
    showCurrentParameterPage("Filter BP2", "On");
  }
  if (filterBP2SWL && lowerSW) {
    green.writePin(GREEN_FILT_HP_LED, LOW);
    green.writePin(GREEN_FILT_BP2_LED, HIGH);
    green.writePin(GREEN_FILT_BP1_LED, LOW);
    green.writePin(GREEN_FILT_LP2_LED, LOW);
    green.writePin(GREEN_FILT_LP1_LED, LOW);
    sr.writePin(FILT_HP_LED, LOW);
    sr.writePin(FILT_BP2_LED, LOW);
    sr.writePin(FILT_BP1_LED, LOW);
    sr.writePin(FILT_LP2_LED, LOW);
    sr.writePin(FILT_LP1_LED, LOW);
    filterHPSWL = 0;
    filterBP1SWL = 0;
    filterLP2SWL = 0;
    filterLP1SWL = 0;
  }
  if (filterBP2SWU && upperSW) {
    sr.writePin(FILT_HP_LED, LOW);
    sr.writePin(FILT_BP2_LED, HIGH);
    sr.writePin(FILT_BP1_LED, LOW);
    sr.writePin(FILT_LP2_LED, LOW);
    sr.writePin(FILT_LP1_LED, LOW);
    green.writePin(GREEN_FILT_HP_LED, LOW);
    green.writePin(GREEN_FILT_BP2_LED, LOW);
    green.writePin(GREEN_FILT_BP1_LED, LOW);
    green.writePin(GREEN_FILT_LP2_LED, LOW);
    green.writePin(GREEN_FILT_LP1_LED, LOW);
    filterHPSWU = 0;
    filterBP1SWU = 0;
    filterLP2SWU = 0;
    filterLP1SWU = 0;
  }

  if (!layerPatchFlag) {
    if (upperSW && filterBP2SWU) {
      midiCCOut(MIDIfilterU, 75);
    }
    if (lowerSW && filterBP2SWL) {
      midiCCOut(MIDIfilterL, 75);
    }
  }
}

void updatefilterBP1SW() {
  if (!recallPatchFlag) {
    showCurrentParameterPage("Filter BP1", "On");
  }
  if (filterBP1SWL && lowerSW) {
    green.writePin(GREEN_FILT_HP_LED, LOW);
    green.writePin(GREEN_FILT_BP2_LED, LOW);
    green.writePin(GREEN_FILT_BP1_LED, HIGH);
    green.writePin(GREEN_FILT_LP2_LED, LOW);
    green.writePin(GREEN_FILT_LP1_LED, LOW);
    sr.writePin(FILT_HP_LED, LOW);
    sr.writePin(FILT_BP2_LED, LOW);
    sr.writePin(FILT_BP1_LED, LOW);
    sr.writePin(FILT_LP2_LED, LOW);
    sr.writePin(FILT_LP1_LED, LOW);
    filterHPSWL = 0;
    filterBP2SWL = 0;
    filterLP2SWL = 0;
    filterLP1SWL = 0;
  }
  if (filterBP1SWU && upperSW) {
    sr.writePin(FILT_HP_LED, LOW);
    sr.writePin(FILT_BP2_LED, LOW);
    sr.writePin(FILT_BP1_LED, HIGH);
    sr.writePin(FILT_LP2_LED, LOW);
    sr.writePin(FILT_LP1_LED, LOW);
    green.writePin(GREEN_FILT_HP_LED, LOW);
    green.writePin(GREEN_FILT_BP2_LED, LOW);
    green.writePin(GREEN_FILT_BP1_LED, LOW);
    green.writePin(GREEN_FILT_LP2_LED, LOW);
    green.writePin(GREEN_FILT_LP1_LED, LOW);
    filterHPSWU = 0;
    filterBP2SWU = 0;
    filterLP2SWU = 0;
    filterLP1SWU = 0;
  }

  if (!layerPatchFlag) {
    if (upperSW && filterBP1SWU) {
      midiCCOut(MIDIfilterU, 85);
    }
    if (lowerSW && filterBP1SWL) {
      midiCCOut(MIDIfilterL, 85);
    }
  }
}

void updatefilterLP2SW() {
  if (!recallPatchFlag) {
    showCurrentParameterPage("Filter LP2", "On");
  }
  if (filterLP2SWL && lowerSW) {
    green.writePin(GREEN_FILT_HP_LED, LOW);
    green.writePin(GREEN_FILT_BP2_LED, LOW);
    green.writePin(GREEN_FILT_BP1_LED, LOW);
    green.writePin(GREEN_FILT_LP2_LED, HIGH);
    green.writePin(GREEN_FILT_LP1_LED, LOW);
    sr.writePin(FILT_HP_LED, LOW);
    sr.writePin(FILT_BP2_LED, LOW);
    sr.writePin(FILT_BP1_LED, LOW);
    sr.writePin(FILT_LP2_LED, LOW);
    sr.writePin(FILT_LP1_LED, LOW);
    filterHPSWL = 0;
    filterBP2SWL = 0;
    filterBP1SWL = 0;
    filterLP1SWL = 0;
  }
  if (filterLP2SWU && upperSW) {
    sr.writePin(FILT_HP_LED, LOW);
    sr.writePin(FILT_BP2_LED, LOW);
    sr.writePin(FILT_BP1_LED, LOW);
    sr.writePin(FILT_LP2_LED, HIGH);
    sr.writePin(FILT_LP1_LED, LOW);
    green.writePin(GREEN_FILT_HP_LED, LOW);
    green.writePin(GREEN_FILT_BP2_LED, LOW);
    green.writePin(GREEN_FILT_BP1_LED, LOW);
    green.writePin(GREEN_FILT_LP2_LED, LOW);
    green.writePin(GREEN_FILT_LP1_LED, LOW);
    filterHPSWU = 0;
    filterBP2SWU = 0;
    filterBP1SWU = 0;
    filterLP1SWU = 0;
  }

  if (!layerPatchFlag) {
    if (upperSW && filterLP2SWU) {
      midiCCOut(MIDIfilterU, 97);
    }
    if (lowerSW && filterLP2SWL) {
      midiCCOut(MIDIfilterL, 97);
    }
  }
}

void updatefilterLP1SW() {
  if (!recallPatchFlag) {
    showCurrentParameterPage("Filter LP1", "On");
  }
  if (filterLP1SWL && lowerSW) {
    green.writePin(GREEN_FILT_HP_LED, LOW);
    green.writePin(GREEN_FILT_BP2_LED, LOW);
    green.writePin(GREEN_FILT_BP1_LED, LOW);
    green.writePin(GREEN_FILT_LP2_LED, LOW);
    green.writePin(GREEN_FILT_LP1_LED, HIGH);
    sr.writePin(FILT_HP_LED, LOW);
    sr.writePin(FILT_BP2_LED, LOW);
    sr.writePin(FILT_BP1_LED, LOW);
    sr.writePin(FILT_LP2_LED, LOW);
    sr.writePin(FILT_LP1_LED, LOW);
    filterHPSWL = 0;
    filterBP2SWL = 0;
    filterLP2SWL = 0;
    filterBP1SWL = 0;
  }
  if (filterLP1SWU && upperSW) {
    sr.writePin(FILT_HP_LED, LOW);
    sr.writePin(FILT_BP2_LED, LOW);
    sr.writePin(FILT_BP1_LED, LOW);
    sr.writePin(FILT_LP2_LED, LOW);
    sr.writePin(FILT_LP1_LED, HIGH);
    green.writePin(GREEN_FILT_HP_LED, LOW);
    green.writePin(GREEN_FILT_BP2_LED, LOW);
    green.writePin(GREEN_FILT_BP1_LED, LOW);
    green.writePin(GREEN_FILT_LP2_LED, LOW);
    green.writePin(GREEN_FILT_LP1_LED, LOW);
    filterHPSWU = 0;
    filterBP2SWU = 0;
    filterLP2SWU = 0;
    filterBP1SWU = 0;
  }

  if (!layerPatchFlag) {
    if (upperSW && filterLP1SWU) {
      midiCCOut(MIDIfilterU, 120);
    }
    if (lowerSW && filterLP1SWL) {
      midiCCOut(MIDIfilterL, 120);
    }
  }
}

void updaterevGLTCSW() {
  if (!recallPatchFlag) {
    showCurrentParameterPage("Reverb GLTC", "On");
  }
  if (revGLTCSWL && lowerSW) {
    green.writePin(GREEN_REV_GLTC_LED, HIGH);
    green.writePin(GREEN_REV_HALL_LED, LOW);
    green.writePin(GREEN_REV_PLT_LED, LOW);
    green.writePin(GREEN_REV_ROOM_LED, LOW);
    sr.writePin(REV_GLTC_LED, LOW);
    sr.writePin(REV_HALL_LED, LOW);
    sr.writePin(REV_PLT_LED, LOW);
    sr.writePin(REV_ROOM_LED, LOW);
    revHallSWL = 0;
    revPlateSWL = 0;
    revRoomSWL = 0;
    revOffSWL = 0;
  }
  if (revGLTCSWU && upperSW) {
    sr.writePin(REV_GLTC_LED, HIGH);
    sr.writePin(REV_HALL_LED, LOW);
    sr.writePin(REV_PLT_LED, LOW);
    sr.writePin(REV_ROOM_LED, LOW);
    green.writePin(GREEN_REV_GLTC_LED, LOW);
    green.writePin(GREEN_REV_HALL_LED, LOW);
    green.writePin(GREEN_REV_PLT_LED, LOW);
    green.writePin(GREEN_REV_ROOM_LED, LOW);
    revHallSWU = 0;
    revPlateSWU = 0;
    revRoomSWU = 0;
    revOffSWU = 0;
  }

  if (!layerPatchFlag) {
    if (upperSW && revGLTCSWU) {
      midiCCOut(MIDIreverbU, 65);
    }
    if (lowerSW && revGLTCSWL) {
      midiCCOut(MIDIreverbL, 65);
    }
  }
}

void updaterevHallSW() {
  if (!recallPatchFlag) {
    showCurrentParameterPage("Reverb Hall", "On");
  }
  if (revHallSWL && lowerSW) {
    green.writePin(GREEN_REV_GLTC_LED, LOW);
    green.writePin(GREEN_REV_HALL_LED, HIGH);
    green.writePin(GREEN_REV_PLT_LED, LOW);
    green.writePin(GREEN_REV_ROOM_LED, LOW);
    sr.writePin(REV_GLTC_LED, LOW);
    sr.writePin(REV_HALL_LED, LOW);
    sr.writePin(REV_PLT_LED, LOW);
    sr.writePin(REV_ROOM_LED, LOW);
    revGLTCSWL = 0;
    revPlateSWL = 0;
    revRoomSWL = 0;
    revOffSWL = 0;
  }
  if (revHallSWU && upperSW) {
    sr.writePin(REV_GLTC_LED, LOW);
    sr.writePin(REV_HALL_LED, HIGH);
    sr.writePin(REV_PLT_LED, LOW);
    sr.writePin(REV_ROOM_LED, LOW);
    green.writePin(GREEN_REV_GLTC_LED, LOW);
    green.writePin(GREEN_REV_HALL_LED, LOW);
    green.writePin(GREEN_REV_PLT_LED, LOW);
    green.writePin(GREEN_REV_ROOM_LED, LOW);
    revGLTCSWU = 0;
    revPlateSWU = 0;
    revRoomSWU = 0;
    revOffSWU = 0;
  }

  if (!layerPatchFlag) {
    if (upperSW && revHallSWU) {
      midiCCOut(MIDIreverbU, 75);
    }
    if (lowerSW && revHallSWL) {
      midiCCOut(MIDIreverbL, 75);
    }
  }
}

void updaterevPlateSW() {
  if (!recallPatchFlag) {
    showCurrentParameterPage("Reverb Plate", "On");
  }
  if (revPlateSWL && lowerSW) {
    green.writePin(GREEN_REV_GLTC_LED, LOW);
    green.writePin(GREEN_REV_HALL_LED, LOW);
    green.writePin(GREEN_REV_PLT_LED, HIGH);
    green.writePin(GREEN_REV_ROOM_LED, LOW);
    sr.writePin(REV_GLTC_LED, LOW);
    sr.writePin(REV_HALL_LED, LOW);
    sr.writePin(REV_PLT_LED, LOW);
    sr.writePin(REV_ROOM_LED, LOW);
    revGLTCSWL = 0;
    revHallSWL = 0;
    revRoomSWL = 0;
    revOffSWL = 0;
  }
  if (revPlateSWU && upperSW) {
    sr.writePin(REV_GLTC_LED, LOW);
    sr.writePin(REV_HALL_LED, LOW);
    sr.writePin(REV_PLT_LED, HIGH);
    sr.writePin(REV_ROOM_LED, LOW);
    green.writePin(GREEN_REV_GLTC_LED, LOW);
    green.writePin(GREEN_REV_HALL_LED, LOW);
    green.writePin(GREEN_REV_PLT_LED, LOW);
    green.writePin(GREEN_REV_ROOM_LED, LOW);
    revGLTCSWU = 0;
    revHallSWU = 0;
    revRoomSWU = 0;
    revOffSWU = 0;
  }

  if (!layerPatchFlag) {
    if (upperSW && revPlateSWU) {
      midiCCOut(MIDIreverbU, 85);
    }
    if (lowerSW && revPlateSWL) {
      midiCCOut(MIDIreverbL, 85);
    }
  }
}

void updaterevRoomSW() {
  if (!recallPatchFlag) {
    showCurrentParameterPage("Reverb Room", "On");
  }
  if (revRoomSWL && lowerSW) {
    green.writePin(GREEN_REV_GLTC_LED, LOW);
    green.writePin(GREEN_REV_HALL_LED, LOW);
    green.writePin(GREEN_REV_PLT_LED, LOW);
    green.writePin(GREEN_REV_ROOM_LED, HIGH);
    sr.writePin(REV_GLTC_LED, LOW);
    sr.writePin(REV_HALL_LED, LOW);
    sr.writePin(REV_PLT_LED, LOW);
    sr.writePin(REV_ROOM_LED, LOW);
    revGLTCSWL = 0;
    revHallSWL = 0;
    revPlateSWL = 0;
    revOffSWL = 0;
  }
  if (revRoomSWU && upperSW) {
    sr.writePin(REV_GLTC_LED, LOW);
    sr.writePin(REV_HALL_LED, LOW);
    sr.writePin(REV_PLT_LED, LOW);
    sr.writePin(REV_ROOM_LED, HIGH);
    green.writePin(GREEN_REV_GLTC_LED, LOW);
    green.writePin(GREEN_REV_HALL_LED, LOW);
    green.writePin(GREEN_REV_PLT_LED, LOW);
    green.writePin(GREEN_REV_ROOM_LED, LOW);
    revGLTCSWU = 0;
    revHallSWU = 0;
    revPlateSWU = 0;
    revOffSWU = 0;
  }

  if (!layerPatchFlag) {
    if (upperSW && revRoomSWU) {
      midiCCOut(MIDIreverbU, 97);
    }
    if (lowerSW && revRoomSWL) {
      midiCCOut(MIDIreverbL, 97);
    }
  }
}

void updaterevOffSW() {
  if (!recallPatchFlag) {
    showCurrentParameterPage("Reverb", "Off");
  }
  if (revOffSWL && lowerSW) {
    green.writePin(GREEN_REV_GLTC_LED, LOW);
    green.writePin(GREEN_REV_HALL_LED, LOW);
    green.writePin(GREEN_REV_PLT_LED, LOW);
    green.writePin(GREEN_REV_ROOM_LED, LOW);
    sr.writePin(REV_GLTC_LED, LOW);
    sr.writePin(REV_HALL_LED, LOW);
    sr.writePin(REV_PLT_LED, LOW);
    sr.writePin(REV_ROOM_LED, LOW);
    revGLTCSWL = 0;
    revHallSWL = 0;
    revPlateSWL = 0;
    revRoomSWL = 0;
  }
  if (revOffSWU && upperSW) {
    sr.writePin(REV_GLTC_LED, LOW);
    sr.writePin(REV_HALL_LED, LOW);
    sr.writePin(REV_PLT_LED, LOW);
    sr.writePin(REV_ROOM_LED, LOW);
    green.writePin(GREEN_REV_GLTC_LED, LOW);
    green.writePin(GREEN_REV_HALL_LED, LOW);
    green.writePin(GREEN_REV_PLT_LED, LOW);
    green.writePin(GREEN_REV_ROOM_LED, LOW);
    revGLTCSWU = 0;
    revHallSWU = 0;
    revPlateSWU = 0;
    revRoomSWU = 0;
  }

  if (!layerPatchFlag) {
    if (upperSW && revOffSWU) {
      midiCCOut(MIDIreverbU, 120);
    }
    if (lowerSW && revOffSWL) {
      midiCCOut(MIDIreverbL, 120);
    }
  }
}

void updatenoisePinkSW() {
  if (!recallPatchFlag) {
    showCurrentParameterPage("Pink Noise", "On");
  }
  if (noisePinkSWL && lowerSW) {
    green.writePin(GREEN_PINK_LED, HIGH);
    green.writePin(GREEN_WHITE_LED, LOW);
    sr.writePin(PINK_LED, LOW);
    sr.writePin(WHITE_LED, LOW);
    noiseWhiteSWL = 0;
    noiseOffSWL = 0;
  }
  if (noisePinkSWU && upperSW) {
    sr.writePin(PINK_LED, HIGH);
    sr.writePin(WHITE_LED, LOW);
    green.writePin(GREEN_PINK_LED, LOW);
    green.writePin(GREEN_WHITE_LED, LOW);
    noiseWhiteSWU = 0;
    noiseOffSWU = 0;
  }

  if (!layerPatchFlag) {
    if (upperSW && noisePinkSWU) {
      midiCCOut(MIDInoiseU, 85);
    }
    if (lowerSW && noisePinkSWL) {
      midiCCOut(MIDInoiseL, 85);
    }
  }
}

void updatenoiseWhiteSW() {
  if (!recallPatchFlag) {
    showCurrentParameterPage("White Noise", "On");
  }
  if (noiseWhiteSWL && lowerSW) {
    green.writePin(GREEN_PINK_LED, LOW);
    green.writePin(GREEN_WHITE_LED, HIGH);
    sr.writePin(PINK_LED, LOW);
    sr.writePin(WHITE_LED, LOW);
    noisePinkSWL = 0;
    noiseOffSWL = 0;
  }
  if (noiseWhiteSWU && upperSW) {
    sr.writePin(PINK_LED, LOW);
    sr.writePin(WHITE_LED, HIGH);
    green.writePin(GREEN_PINK_LED, LOW);
    green.writePin(GREEN_WHITE_LED, LOW);
    noisePinkSWU = 0;
    noiseOffSWU = 0;
  }

  if (!layerPatchFlag) {
    if (upperSW && noiseWhiteSWU) {
      midiCCOut(MIDInoiseU, 75);
    }
    if (lowerSW && noiseWhiteSWL) {
      midiCCOut(MIDInoiseL, 75);
    }
  }
}

void updatenoiseOffSW() {
  if (!recallPatchFlag) {
    showCurrentParameterPage("Noise", "Off");
  }
  if (noiseOffSWL && lowerSW) {
    green.writePin(GREEN_PINK_LED, LOW);
    green.writePin(GREEN_WHITE_LED, LOW);
    sr.writePin(PINK_LED, LOW);
    sr.writePin(WHITE_LED, LOW);
    noisePinkSWL = 0;
    noiseWhiteSWL = 0;
  }
  if (noiseOffSWU && upperSW) {
    sr.writePin(PINK_LED, LOW);
    sr.writePin(WHITE_LED, LOW);
    green.writePin(GREEN_PINK_LED, LOW);
    green.writePin(GREEN_WHITE_LED, LOW);
    noisePinkSWU = 0;
    noiseWhiteSWU = 0;
  }

  if (!layerPatchFlag) {
    if (upperSW && noiseOffSWU) {
      midiCCOut(MIDInoiseU, 65);
    }
    if (lowerSW && noiseOffSWL) {
      midiCCOut(MIDInoiseL, 65);
    }
  }
}

void updateechoSyncSW() {

  if (echoSyncSWL && lowerSW) {
    green.writePin(GREEN_ECHO_SYNC_LED, HIGH);
    sr.writePin(ECHO_SYNC_LED, LOW);
    if (!recallPatchFlag) {
      showCurrentParameterPage("Echo Sync", "Lower On");
    }
    if (!layerPatchFlag) {
      midiCCOut(MIDIechoSyncL, 127);
    }
    echoSyncSW = 1;
  }
  if (!echoSyncSWL && lowerSW) {
    green.writePin(GREEN_ECHO_SYNC_LED, LOW);
    sr.writePin(ECHO_SYNC_LED, LOW);
    if (!recallPatchFlag) {
      showCurrentParameterPage("Echo Sync", "Lower Off");
      if (!layerPatchFlag) {
        midiCCOut(MIDIechoSyncL, 127);
      }
    }
    echoSyncSW = 0;
  }
  if (echoSyncSWU && upperSW) {
    sr.writePin(ECHO_SYNC_LED, HIGH);
    green.writePin(GREEN_ECHO_SYNC_LED, LOW);
    if (!recallPatchFlag) {
      showCurrentParameterPage("Echo Sync", "Upper On");
    }
    if (!layerPatchFlag) {
      midiCCOut(MIDIechoSyncU, 127);
    }
    echoSyncSW = 1;
  }
  if (!echoSyncSWU && upperSW) {
    sr.writePin(ECHO_SYNC_LED, LOW);
    green.writePin(GREEN_ECHO_SYNC_LED, LOW);
    if (!recallPatchFlag) {
      showCurrentParameterPage("Echo Sync", "Upper Off");
      if (!layerPatchFlag) {
        midiCCOut(MIDIechoSyncU, 127);
      }
    }
    echoSyncSW = 0;
  }
}

void updateosc1ringModSW() {

  if (osc1ringModSWL && lowerSW) {
    green.writePin(GREEN_OSC1_RINGMOD_LED, HIGH);
    sr.writePin(OSC1_RINGMOD_LED, LOW);
    if (!recallPatchFlag) {
      showCurrentParameterPage("OSC1 RM", "Lower On");
    }
    if (!layerPatchFlag) {
      midiCCOut(MIDIosc1ringL, 127);
    }
    osc1ringModSW = 1;
  }
  if (!osc1ringModSWL && lowerSW) {
    green.writePin(GREEN_OSC1_RINGMOD_LED, LOW);
    sr.writePin(OSC1_RINGMOD_LED, LOW);
    if (!recallPatchFlag) {
      showCurrentParameterPage("OSC1 RM", "Lower Off");
      if (!layerPatchFlag) {
        midiCCOut(MIDIosc1ringL, 127);
      }
    }
    osc1ringModSW = 0;
  }
  if (osc1ringModSWU && upperSW) {
    sr.writePin(OSC1_RINGMOD_LED, HIGH);
    green.writePin(GREEN_OSC1_RINGMOD_LED, LOW);
    if (!recallPatchFlag) {
      showCurrentParameterPage("OSC1 RM", "Upper On");
    }
    if (!layerPatchFlag) {
      midiCCOut(MIDIosc1ringU, 127);
    }
    osc1ringModSW = 1;
  }
  if (!osc1ringModSWU && upperSW) {
    sr.writePin(OSC1_RINGMOD_LED, LOW);
    green.writePin(GREEN_OSC1_RINGMOD_LED, LOW);
    if (!recallPatchFlag) {
      showCurrentParameterPage("OSC1 RM", "Upper Off");
      if (!layerPatchFlag) {
        midiCCOut(MIDIosc1ringU, 127);
      }
    }
    osc1ringModSW = 0;
  }
}

void updateosc2ringModSW() {

  if (osc2ringModSWL && lowerSW) {
    green.writePin(GREEN_OSC2_RINGMOD_LED, HIGH);
    sr.writePin(OSC2_RINGMOD_LED, LOW);
    if (!recallPatchFlag) {
      showCurrentParameterPage("OSC2 RM", "Lower On");
    }
    if (!layerPatchFlag) {
      midiCCOut(MIDIosc2ringL, 127);
    }
    osc2ringModSW = 1;
  }
  if (!osc2ringModSWL && lowerSW) {
    green.writePin(GREEN_OSC2_RINGMOD_LED, LOW);
    sr.writePin(OSC2_RINGMOD_LED, LOW);
    if (!recallPatchFlag) {
      showCurrentParameterPage("OSC2 RM", "Lower Off");
      if (!layerPatchFlag) {
        midiCCOut(MIDIosc2ringL, 127);
      }
    }
    osc2ringModSW = 0;
  }
  if (osc2ringModSWU && upperSW) {
    sr.writePin(OSC2_RINGMOD_LED, HIGH);
    green.writePin(GREEN_OSC2_RINGMOD_LED, LOW);
    if (!recallPatchFlag) {
      showCurrentParameterPage("OSC2 RM", "Upper On");
    }
    if (!layerPatchFlag) {
      midiCCOut(MIDIosc2ringU, 127);
    }
    osc2ringModSW = 1;
  }
  if (!osc2ringModSWU && upperSW) {
    sr.writePin(OSC2_RINGMOD_LED, LOW);
    green.writePin(GREEN_OSC2_RINGMOD_LED, LOW);
    if (!recallPatchFlag) {
      showCurrentParameterPage("OSC2 RM", "Upper Off");
      if (!layerPatchFlag) {
        midiCCOut(MIDIosc2ringU, 127);
      }
    }
    osc2ringModSW = 0;
  }
}

void updateosc1_osc2PWMSW() {
  if (!recallPatchFlag) {
    showCurrentParameterPage("OSC2 PWM", "On");
  }
  if (osc1_osc2PWMSWL && lowerSW) {
    green.writePin(GREEN_OSC1_OSC2_PWM_LED, HIGH);
    green.writePin(GREEN_OSC1_PULSE_LED, LOW);
    green.writePin(GREEN_OSC1_SQUARE_LED, LOW);
    green.writePin(GREEN_OSC1_SAW_LED, LOW);
    green.writePin(GREEN_OSC1_TRIANGLE_LED, LOW);
    sr.writePin(OSC1_OSC2_PWM_LED, LOW);
    sr.writePin(OSC1_PULSE_LED, LOW);
    sr.writePin(OSC1_SQUARE_LED, LOW);
    sr.writePin(OSC1_SAW_LED, LOW);
    sr.writePin(OSC1_TRIANGLE_LED, LOW);
    osc1pulseSWL = 0;
    osc1squareSWL = 0;
    osc1sawSWL = 0;
    osc1triangleSWL = 0;
  }
  if (osc1_osc2PWMSWU && upperSW) {
    sr.writePin(OSC1_OSC2_PWM_LED, HIGH);
    sr.writePin(OSC1_PULSE_LED, LOW);
    sr.writePin(OSC1_SQUARE_LED, LOW);
    sr.writePin(OSC1_SAW_LED, LOW);
    sr.writePin(OSC1_TRIANGLE_LED, LOW);
    green.writePin(GREEN_OSC1_OSC2_PWM_LED, LOW);
    green.writePin(GREEN_OSC1_PULSE_LED, LOW);
    green.writePin(GREEN_OSC1_SQUARE_LED, LOW);
    green.writePin(GREEN_OSC1_SAW_LED, LOW);
    green.writePin(GREEN_OSC1_TRIANGLE_LED, LOW);
    osc1pulseSWU = 0;
    osc1squareSWU = 0;
    osc1sawSWU = 0;
    osc1triangleSWU = 0;
  }

  if (!layerPatchFlag) {
    if (upperSW && osc1_osc2PWMSWU) {
      midiCCOut(MIDIosc1WaveU, 120);
    }
    if (lowerSW && osc1_osc2PWMSWL) {
      midiCCOut(MIDIosc1WaveL, 65);
    }
  }
}

void updateosc1pulseSW() {
  if (!recallPatchFlag) {
    showCurrentParameterPage("OSC1 Pulse", "On");
  }
  if (osc1pulseSWL && lowerSW) {
    green.writePin(GREEN_OSC1_OSC2_PWM_LED, LOW);
    green.writePin(GREEN_OSC1_PULSE_LED, HIGH);
    green.writePin(GREEN_OSC1_SQUARE_LED, LOW);
    green.writePin(GREEN_OSC1_SAW_LED, LOW);
    green.writePin(GREEN_OSC1_TRIANGLE_LED, LOW);
    sr.writePin(OSC1_OSC2_PWM_LED, LOW);
    sr.writePin(OSC1_PULSE_LED, LOW);
    sr.writePin(OSC1_SQUARE_LED, LOW);
    sr.writePin(OSC1_SAW_LED, LOW);
    sr.writePin(OSC1_TRIANGLE_LED, LOW);
    osc1_osc2PWMSWL = 0;
    osc1squareSWL = 0;
    osc1sawSWL = 0;
    osc1triangleSWL = 0;
  }
  if (osc1pulseSWU && upperSW) {
    sr.writePin(OSC1_OSC2_PWM_LED, LOW);
    sr.writePin(OSC1_PULSE_LED, HIGH);
    sr.writePin(OSC1_SQUARE_LED, LOW);
    sr.writePin(OSC1_SAW_LED, LOW);
    sr.writePin(OSC1_TRIANGLE_LED, LOW);
    green.writePin(GREEN_OSC1_OSC2_PWM_LED, LOW);
    green.writePin(GREEN_OSC1_PULSE_LED, LOW);
    green.writePin(GREEN_OSC1_SQUARE_LED, LOW);
    green.writePin(GREEN_OSC1_SAW_LED, LOW);
    green.writePin(GREEN_OSC1_TRIANGLE_LED, LOW);
    osc1_osc2PWMSWU = 0;
    osc1squareSWU = 0;
    osc1sawSWU = 0;
    osc1triangleSWU = 0;
  }

  if (!layerPatchFlag) {
    if (upperSW && osc1pulseSWU) {
      midiCCOut(MIDIosc1WaveU, 97);
    }
    if (lowerSW && osc1pulseSWL) {
      midiCCOut(MIDIosc1WaveL, 75);
    }
  }
}

void updateosc1squareSW() {
  if (!recallPatchFlag) {
    showCurrentParameterPage("OSC1 Square", "On");
  }
  if (osc1squareSWL && lowerSW) {
    green.writePin(GREEN_OSC1_OSC2_PWM_LED, LOW);
    green.writePin(GREEN_OSC1_PULSE_LED, LOW);
    green.writePin(GREEN_OSC1_SQUARE_LED, HIGH);
    green.writePin(GREEN_OSC1_SAW_LED, LOW);
    green.writePin(GREEN_OSC1_TRIANGLE_LED, LOW);
    sr.writePin(OSC1_OSC2_PWM_LED, LOW);
    sr.writePin(OSC1_PULSE_LED, LOW);
    sr.writePin(OSC1_SQUARE_LED, LOW);
    sr.writePin(OSC1_SAW_LED, LOW);
    sr.writePin(OSC1_TRIANGLE_LED, LOW);
    osc1_osc2PWMSWL = 0;
    osc1pulseSWL = 0;
    osc1sawSWL = 0;
    osc1triangleSWL = 0;
  }
  if (osc1squareSWU && upperSW) {
    sr.writePin(OSC1_OSC2_PWM_LED, LOW);
    sr.writePin(OSC1_PULSE_LED, LOW);
    sr.writePin(OSC1_SQUARE_LED, HIGH);
    sr.writePin(OSC1_SAW_LED, LOW);
    sr.writePin(OSC1_TRIANGLE_LED, LOW);
    green.writePin(GREEN_OSC1_OSC2_PWM_LED, LOW);
    green.writePin(GREEN_OSC1_PULSE_LED, LOW);
    green.writePin(GREEN_OSC1_SQUARE_LED, LOW);
    green.writePin(GREEN_OSC1_SAW_LED, LOW);
    green.writePin(GREEN_OSC1_TRIANGLE_LED, LOW);
    osc1_osc2PWMSWU = 0;
    osc1pulseSWU = 0;
    osc1sawSWU = 0;
    osc1triangleSWU = 0;
  }

  if (!layerPatchFlag) {
    if (upperSW && osc1squareSWU) {
      midiCCOut(MIDIosc1WaveU, 85);
    }
    if (lowerSW && osc1squareSWL) {
      midiCCOut(MIDIosc1WaveL, 85);
    }
  }
}

void updateosc1sawSW() {
  if (!recallPatchFlag) {
    showCurrentParameterPage("OSC1 Saw", "On");
  }
  if (osc1sawSWL && lowerSW) {
    green.writePin(GREEN_OSC1_OSC2_PWM_LED, LOW);
    green.writePin(GREEN_OSC1_PULSE_LED, LOW);
    green.writePin(GREEN_OSC1_SQUARE_LED, LOW);
    green.writePin(GREEN_OSC1_SAW_LED, HIGH);
    green.writePin(GREEN_OSC1_TRIANGLE_LED, LOW);
    sr.writePin(OSC1_OSC2_PWM_LED, LOW);
    sr.writePin(OSC1_PULSE_LED, LOW);
    sr.writePin(OSC1_SQUARE_LED, LOW);
    sr.writePin(OSC1_SAW_LED, LOW);
    sr.writePin(OSC1_TRIANGLE_LED, LOW);
    osc1_osc2PWMSWL = 0;
    osc1pulseSWL = 0;
    osc1squareSWL = 0;
    osc1triangleSWL = 0;
  }
  if (osc1sawSWU && upperSW) {
    sr.writePin(OSC1_OSC2_PWM_LED, LOW);
    sr.writePin(OSC1_PULSE_LED, LOW);
    sr.writePin(OSC1_SQUARE_LED, LOW);
    sr.writePin(OSC1_SAW_LED, HIGH);
    sr.writePin(OSC1_TRIANGLE_LED, LOW);
    green.writePin(GREEN_OSC1_OSC2_PWM_LED, LOW);
    green.writePin(GREEN_OSC1_PULSE_LED, LOW);
    green.writePin(GREEN_OSC1_SQUARE_LED, LOW);
    green.writePin(GREEN_OSC1_SAW_LED, LOW);
    green.writePin(GREEN_OSC1_TRIANGLE_LED, LOW);
    osc1_osc2PWMSWU = 0;
    osc1pulseSWU = 0;
    osc1squareSWU = 0;
    osc1triangleSWU = 0;
  }

  if (!layerPatchFlag) {
    if (upperSW && osc1sawSWU) {
      midiCCOut(MIDIosc1WaveU, 75);
    }
    if (lowerSW && osc1sawSWL) {
      midiCCOut(MIDIosc1WaveL, 97);
    }
  }
}

void updateosc1triangleSW() {
  if (!recallPatchFlag) {
    showCurrentParameterPage("OSC1 Triangle", "On");
  }
  if (osc1triangleSWL && lowerSW) {
    green.writePin(GREEN_OSC1_OSC2_PWM_LED, LOW);
    green.writePin(GREEN_OSC1_PULSE_LED, LOW);
    green.writePin(GREEN_OSC1_SQUARE_LED, LOW);
    green.writePin(GREEN_OSC1_SAW_LED, LOW);
    green.writePin(GREEN_OSC1_TRIANGLE_LED, HIGH);
    sr.writePin(OSC1_OSC2_PWM_LED, LOW);
    sr.writePin(OSC1_PULSE_LED, LOW);
    sr.writePin(OSC1_SQUARE_LED, LOW);
    sr.writePin(OSC1_SAW_LED, LOW);
    sr.writePin(OSC1_TRIANGLE_LED, LOW);
    osc1_osc2PWMSWL = 0;
    osc1pulseSWL = 0;
    osc1squareSWL = 0;
    osc1sawSWL = 0;
  }
  if (osc1triangleSWU && upperSW) {
    sr.writePin(OSC1_OSC2_PWM_LED, LOW);
    sr.writePin(OSC1_PULSE_LED, LOW);
    sr.writePin(OSC1_SQUARE_LED, LOW);
    sr.writePin(OSC1_SAW_LED, LOW);
    sr.writePin(OSC1_TRIANGLE_LED, HIGH);
    green.writePin(GREEN_OSC1_OSC2_PWM_LED, LOW);
    green.writePin(GREEN_OSC1_PULSE_LED, LOW);
    green.writePin(GREEN_OSC1_SQUARE_LED, LOW);
    green.writePin(GREEN_OSC1_SAW_LED, LOW);
    green.writePin(GREEN_OSC1_TRIANGLE_LED, LOW);
    osc1_osc2PWMSWU = 0;
    osc1pulseSWU = 0;
    osc1squareSWU = 0;
    osc1sawSWU = 0;
  }

  if (!layerPatchFlag) {
    if (upperSW && osc1triangleSWU) {
      midiCCOut(MIDIosc1WaveU, 65);
    }
    if (lowerSW && osc1triangleSWL) {
      midiCCOut(MIDIosc1WaveL, 120);
    }
  }
}

void updateosc2_osc1PWMSW() {
  if (!recallPatchFlag) {
    showCurrentParameterPage("OSC1 PWM", "On");
  }
  if (osc2_osc1PWMSWL && lowerSW) {
    green.writePin(GREEN_OSC2_OSC1_PWM_LED, HIGH);
    green.writePin(GREEN_OSC2_PULSE_LED, LOW);
    green.writePin(GREEN_OSC2_SQUARE_LED, LOW);
    green.writePin(GREEN_OSC2_SAW_LED, LOW);
    green.writePin(GREEN_OSC2_TRIANGLE_LED, LOW);
    sr.writePin(OSC2_OSC1_PWM_LED, LOW);
    sr.writePin(OSC2_PULSE_LED, LOW);
    sr.writePin(OSC2_SQUARE_LED, LOW);
    sr.writePin(OSC2_SAW_LED, LOW);
    sr.writePin(OSC2_TRIANGLE_LED, LOW);
    osc2pulseSWL = 0;
    osc2squareSWL = 0;
    osc2sawSWL = 0;
    osc2triangleSWL = 0;
  }
  if (osc2_osc1PWMSWU && upperSW) {
    sr.writePin(OSC2_OSC1_PWM_LED, HIGH);
    sr.writePin(OSC2_PULSE_LED, LOW);
    sr.writePin(OSC2_SQUARE_LED, LOW);
    sr.writePin(OSC2_SAW_LED, LOW);
    sr.writePin(OSC2_TRIANGLE_LED, LOW);
    green.writePin(GREEN_OSC2_OSC1_PWM_LED, LOW);
    green.writePin(GREEN_OSC2_PULSE_LED, LOW);
    green.writePin(GREEN_OSC2_SQUARE_LED, LOW);
    green.writePin(GREEN_OSC2_SAW_LED, LOW);
    green.writePin(GREEN_OSC2_TRIANGLE_LED, LOW);
    osc2pulseSWU = 0;
    osc2squareSWU = 0;
    osc2sawSWU = 0;
    osc2triangleSWU = 0;
  }

  if (!layerPatchFlag) {
    if (upperSW && osc2_osc1PWMSWU) {
      midiCCOut(MIDIosc2WaveU, 65);
    }
    if (lowerSW && osc2_osc1PWMSWL) {
      midiCCOut(MIDIosc2WaveL, 65);
    }
  }
}

void updateosc2pulseSW() {
  if (!recallPatchFlag) {
    showCurrentParameterPage("OSC2 Pulse", "On");
  }
  if (osc2pulseSWL && lowerSW) {
    green.writePin(GREEN_OSC2_OSC1_PWM_LED, LOW);
    green.writePin(GREEN_OSC2_PULSE_LED, HIGH);
    green.writePin(GREEN_OSC2_SQUARE_LED, LOW);
    green.writePin(GREEN_OSC2_SAW_LED, LOW);
    green.writePin(GREEN_OSC2_TRIANGLE_LED, LOW);
    sr.writePin(OSC2_OSC1_PWM_LED, LOW);
    sr.writePin(OSC2_PULSE_LED, LOW);
    sr.writePin(OSC2_SQUARE_LED, LOW);
    sr.writePin(OSC2_SAW_LED, LOW);
    sr.writePin(OSC2_TRIANGLE_LED, LOW);
    osc2_osc1PWMSWL = 0;
    osc2squareSWL = 0;
    osc2sawSWL = 0;
    osc2triangleSWL = 0;
  }
  if (osc2pulseSWU && upperSW) {
    sr.writePin(OSC2_OSC1_PWM_LED, LOW);
    sr.writePin(OSC2_PULSE_LED, HIGH);
    sr.writePin(OSC2_SQUARE_LED, LOW);
    sr.writePin(OSC2_SAW_LED, LOW);
    sr.writePin(OSC2_TRIANGLE_LED, LOW);
    green.writePin(GREEN_OSC2_OSC1_PWM_LED, LOW);
    green.writePin(GREEN_OSC2_PULSE_LED, LOW);
    green.writePin(GREEN_OSC2_SQUARE_LED, LOW);
    green.writePin(GREEN_OSC2_SAW_LED, LOW);
    green.writePin(GREEN_OSC2_TRIANGLE_LED, LOW);
    osc2_osc1PWMSWU = 0;
    osc2squareSWU = 0;
    osc2sawSWU = 0;
    osc2triangleSWU = 0;
  }

  if (!layerPatchFlag) {
    if (upperSW && osc2pulseSWU) {
      midiCCOut(MIDIosc2WaveU, 75);
    }
    if (lowerSW && osc2pulseSWL) {
      midiCCOut(MIDIosc2WaveL, 75);
    }
  }
}

void updateosc2squareSW() {
  if (!recallPatchFlag) {
    showCurrentParameterPage("OSC2 Square", "On");
  }
  if (osc2squareSWL && lowerSW) {
    green.writePin(GREEN_OSC2_OSC1_PWM_LED, LOW);
    green.writePin(GREEN_OSC2_PULSE_LED, LOW);
    green.writePin(GREEN_OSC2_SQUARE_LED, HIGH);
    green.writePin(GREEN_OSC2_SAW_LED, LOW);
    green.writePin(GREEN_OSC2_TRIANGLE_LED, LOW);
    sr.writePin(OSC2_OSC1_PWM_LED, LOW);
    sr.writePin(OSC2_PULSE_LED, LOW);
    sr.writePin(OSC2_SQUARE_LED, LOW);
    sr.writePin(OSC2_SAW_LED, LOW);
    sr.writePin(OSC2_TRIANGLE_LED, LOW);
    osc2_osc1PWMSWL = 0;
    osc2pulseSWL = 0;
    osc2sawSWL = 0;
    osc2triangleSWL = 0;
  }
  if (osc2squareSWU && upperSW) {
    sr.writePin(OSC2_OSC1_PWM_LED, LOW);
    sr.writePin(OSC2_PULSE_LED, LOW);
    sr.writePin(OSC2_SQUARE_LED, HIGH);
    sr.writePin(OSC2_SAW_LED, LOW);
    sr.writePin(OSC2_TRIANGLE_LED, LOW);
    green.writePin(GREEN_OSC2_OSC1_PWM_LED, LOW);
    green.writePin(GREEN_OSC2_PULSE_LED, LOW);
    green.writePin(GREEN_OSC2_SQUARE_LED, LOW);
    green.writePin(GREEN_OSC2_SAW_LED, LOW);
    green.writePin(GREEN_OSC2_TRIANGLE_LED, LOW);
    osc2_osc1PWMSWU = 0;
    osc2pulseSWU = 0;
    osc2sawSWU = 0;
    osc2triangleSWU = 0;
  }

  if (!layerPatchFlag) {
    if (upperSW && osc2squareSWU) {
      midiCCOut(MIDIosc2WaveU, 85);
    }
    if (lowerSW && osc2squareSWL) {
      midiCCOut(MIDIosc2WaveL, 85);
    }
  }
}

void updateosc2sawSW() {
  if (!recallPatchFlag) {
    showCurrentParameterPage("OSC2 Saw", "On");
  }
  if (osc2sawSWL && lowerSW) {
    green.writePin(GREEN_OSC2_OSC1_PWM_LED, LOW);
    green.writePin(GREEN_OSC2_PULSE_LED, LOW);
    green.writePin(GREEN_OSC2_SQUARE_LED, LOW);
    green.writePin(GREEN_OSC2_SAW_LED, HIGH);
    green.writePin(GREEN_OSC2_TRIANGLE_LED, LOW);
    sr.writePin(OSC2_OSC1_PWM_LED, LOW);
    sr.writePin(OSC2_PULSE_LED, LOW);
    sr.writePin(OSC2_SQUARE_LED, LOW);
    sr.writePin(OSC2_SAW_LED, LOW);
    sr.writePin(OSC2_TRIANGLE_LED, LOW);
    osc2_osc1PWMSWL = 0;
    osc2pulseSWL = 0;
    osc2squareSWL = 0;
    osc2triangleSWL = 0;
  }
  if (osc2sawSWU && upperSW) {
    sr.writePin(OSC2_OSC1_PWM_LED, LOW);
    sr.writePin(OSC2_PULSE_LED, LOW);
    sr.writePin(OSC2_SQUARE_LED, LOW);
    sr.writePin(OSC2_SAW_LED, HIGH);
    sr.writePin(OSC2_TRIANGLE_LED, LOW);
    green.writePin(GREEN_OSC2_OSC1_PWM_LED, LOW);
    green.writePin(GREEN_OSC2_PULSE_LED, LOW);
    green.writePin(GREEN_OSC2_SQUARE_LED, LOW);
    green.writePin(GREEN_OSC2_SAW_LED, LOW);
    green.writePin(GREEN_OSC2_TRIANGLE_LED, LOW);
    osc2_osc1PWMSWU = 0;
    osc2pulseSWU = 0;
    osc2squareSWU = 0;
    osc2triangleSWU = 0;
  }

  if (!layerPatchFlag) {
    if (upperSW && osc2sawSWU) {
      midiCCOut(MIDIosc2WaveU, 97);
    }
    if (lowerSW && osc2sawSWL) {
      midiCCOut(MIDIosc2WaveL, 97);
    }
  }
}

void updateosc2triangleSW() {
  if (!recallPatchFlag) {
    showCurrentParameterPage("OSC2 Triangle", "On");
  }
  if (osc2triangleSWL && lowerSW) {
    green.writePin(GREEN_OSC2_OSC1_PWM_LED, LOW);
    green.writePin(GREEN_OSC2_PULSE_LED, LOW);
    green.writePin(GREEN_OSC2_SQUARE_LED, LOW);
    green.writePin(GREEN_OSC2_SAW_LED, LOW);
    green.writePin(GREEN_OSC2_TRIANGLE_LED, HIGH);
    sr.writePin(OSC2_OSC1_PWM_LED, LOW);
    sr.writePin(OSC2_PULSE_LED, LOW);
    sr.writePin(OSC2_SQUARE_LED, LOW);
    sr.writePin(OSC2_SAW_LED, LOW);
    sr.writePin(OSC2_TRIANGLE_LED, LOW);
    osc2_osc1PWMSWL = 0;
    osc2pulseSWL = 0;
    osc2squareSWL = 0;
    osc2sawSWL = 0;
  }
  if (osc2triangleSWU && upperSW) {
    sr.writePin(OSC2_OSC1_PWM_LED, LOW);
    sr.writePin(OSC2_PULSE_LED, LOW);
    sr.writePin(OSC2_SQUARE_LED, LOW);
    sr.writePin(OSC2_SAW_LED, LOW);
    sr.writePin(OSC2_TRIANGLE_LED, HIGH);
    green.writePin(GREEN_OSC2_OSC1_PWM_LED, LOW);
    green.writePin(GREEN_OSC2_PULSE_LED, LOW);
    green.writePin(GREEN_OSC2_SQUARE_LED, LOW);
    green.writePin(GREEN_OSC2_SAW_LED, LOW);
    green.writePin(GREEN_OSC2_TRIANGLE_LED, LOW);
    osc2_osc1PWMSWU = 0;
    osc2pulseSWU = 0;
    osc2squareSWU = 0;
    osc2sawSWU = 0;
  }

  if (!layerPatchFlag) {
    if (upperSW && osc2triangleSWU) {
      midiCCOut(MIDIosc2WaveU, 120);
    }
    if (lowerSW && osc2triangleSWL) {
      midiCCOut(MIDIosc2WaveL, 120);
    }
  }
}

void updateechoPingPongSW() {
  if (!recallPatchFlag) {
    showCurrentParameterPage("Echo PingPong", "On");
  }
  if (echoPingPongSWL && lowerSW) {
    green.writePin(GREEN_ECHO_PINGPONG_LED, HIGH);
    green.writePin(GREEN_ECHO_TAPE_LED, LOW);
    green.writePin(GREEN_ECHO_STD_LED, LOW);
    sr.writePin(ECHO_PINGPONG_LED, LOW);
    sr.writePin(ECHO_TAPE_LED, LOW);
    sr.writePin(ECHO_STD_LED, LOW);
    echoTapeSWL = 0;
    echoSTDSWL = 0;
    echoOffSWL = 0;
  }
  if (echoPingPongSWU && upperSW) {
    sr.writePin(ECHO_PINGPONG_LED, HIGH);
    sr.writePin(ECHO_TAPE_LED, LOW);
    sr.writePin(ECHO_STD_LED, LOW);
    green.writePin(GREEN_ECHO_PINGPONG_LED, LOW);
    green.writePin(GREEN_ECHO_TAPE_LED, LOW);
    green.writePin(GREEN_ECHO_STD_LED, LOW);
    echoTapeSWU = 0;
    echoSTDSWU = 0;
    echoOffSWU = 0;
  }

  if (!layerPatchFlag) {
    if (upperSW && echoPingPongSWU) {
      midiCCOut(MIDIechoU, 65);
    }
    if (lowerSW && echoPingPongSWL) {
      midiCCOut(MIDIechoL, 65);
    }
  }
}

void updateechoTapeSW() {
  if (!recallPatchFlag) {
    showCurrentParameterPage("Echo Tape", "On");
  }
  if (echoTapeSWL && lowerSW) {
    green.writePin(GREEN_ECHO_PINGPONG_LED, LOW);
    green.writePin(GREEN_ECHO_TAPE_LED, HIGH);
    green.writePin(GREEN_ECHO_STD_LED, LOW);
    sr.writePin(ECHO_PINGPONG_LED, LOW);
    sr.writePin(ECHO_TAPE_LED, LOW);
    sr.writePin(ECHO_STD_LED, LOW);
    echoPingPongSWL = 0;
    echoSTDSWL = 0;
    echoOffSWL = 0;
  }
  if (echoTapeSWU && upperSW) {
    sr.writePin(ECHO_PINGPONG_LED, LOW);
    sr.writePin(ECHO_TAPE_LED, HIGH);
    sr.writePin(ECHO_STD_LED, LOW);
    green.writePin(GREEN_ECHO_PINGPONG_LED, LOW);
    green.writePin(GREEN_ECHO_TAPE_LED, LOW);
    green.writePin(GREEN_ECHO_STD_LED, LOW);
    echoPingPongSWU = 0;
    echoSTDSWU = 0;
    echoOffSWU = 0;
  }

  if (!layerPatchFlag) {
    if (upperSW && echoTapeSWU) {
      midiCCOut(MIDIechoU, 75);
    }
    if (lowerSW && echoTapeSWL) {
      midiCCOut(MIDIechoL, 75);
    }
  }
}

void updateechoSTDSW() {
  if (!recallPatchFlag) {
    showCurrentParameterPage("Echo STD", "On");
  }
  if (echoSTDSWL && lowerSW) {
    green.writePin(GREEN_ECHO_PINGPONG_LED, LOW);
    green.writePin(GREEN_ECHO_TAPE_LED, LOW);
    green.writePin(GREEN_ECHO_STD_LED, HIGH);
    sr.writePin(ECHO_PINGPONG_LED, LOW);
    sr.writePin(ECHO_TAPE_LED, LOW);
    sr.writePin(ECHO_STD_LED, LOW);
    echoPingPongSWL = 0;
    echoTapeSWL = 0;
    echoOffSWL = 0;
  }
  if (echoSTDSWU && upperSW) {
    sr.writePin(ECHO_PINGPONG_LED, LOW);
    sr.writePin(ECHO_TAPE_LED, LOW);
    sr.writePin(ECHO_STD_LED, HIGH);
    green.writePin(GREEN_ECHO_PINGPONG_LED, LOW);
    green.writePin(GREEN_ECHO_TAPE_LED, LOW);
    green.writePin(GREEN_ECHO_STD_LED, LOW);
    echoPingPongSWU = 0;
    echoTapeSWU = 0;
    echoOffSWU = 0;
  }

  if (!layerPatchFlag) {
    if (upperSW && echoSTDSWU) {
      midiCCOut(MIDIechoU, 85);
    }
    if (lowerSW && echoSTDSWL) {
      midiCCOut(MIDIechoL, 85);
    }
  }
}

void updateechoOffSW() {
  if (!recallPatchFlag) {
    showCurrentParameterPage("Echo", "Off");
  }
  if (echoOffSWL && lowerSW) {
    green.writePin(GREEN_ECHO_PINGPONG_LED, LOW);
    green.writePin(GREEN_ECHO_TAPE_LED, LOW);
    green.writePin(GREEN_ECHO_STD_LED, LOW);
    sr.writePin(ECHO_PINGPONG_LED, LOW);
    sr.writePin(ECHO_TAPE_LED, LOW);
    sr.writePin(ECHO_STD_LED, LOW);
    echoPingPongSWL = 0;
    echoTapeSWL = 0;
    echoSTDSWL = 0;
  }
  if (echoOffSWU && upperSW) {
    sr.writePin(ECHO_PINGPONG_LED, LOW);
    sr.writePin(ECHO_TAPE_LED, LOW);
    sr.writePin(ECHO_STD_LED, LOW);
    green.writePin(GREEN_ECHO_PINGPONG_LED, LOW);
    green.writePin(GREEN_ECHO_TAPE_LED, LOW);
    green.writePin(GREEN_ECHO_STD_LED, LOW);
    echoPingPongSWU = 0;
    echoTapeSWU = 0;
    echoSTDSWU = 0;
  }

  if (!layerPatchFlag) {
    if (upperSW && echoOffSWU) {
      midiCCOut(MIDIechoU, 97);
    }
    if (lowerSW && echoOffSWL) {
      midiCCOut(MIDIechoL, 97);
    }
  }
}

void updatechorus3SW() {
  if (!recallPatchFlag) {
    showCurrentParameterPage("Chorus 3", "On");
  }
  if (chorus3SWL && lowerSW) {
    green.writePin(GREEN_CHORUS_3_LED, HIGH);
    green.writePin(GREEN_CHORUS_2_LED, LOW);
    green.writePin(GREEN_CHORUS_1_LED, LOW);
    sr.writePin(CHORUS_3_LED, LOW);
    sr.writePin(CHORUS_2_LED, LOW);
    sr.writePin(CHORUS_1_LED, LOW);
    chorus2SWL = 0;
    chorus1SWL = 0;
    chorusOffSWL = 0;
  }
  if (chorus3SWU && upperSW) {
    sr.writePin(CHORUS_3_LED, HIGH);
    sr.writePin(CHORUS_2_LED, LOW);
    sr.writePin(CHORUS_1_LED, LOW);
    green.writePin(GREEN_CHORUS_3_LED, LOW);
    green.writePin(GREEN_CHORUS_2_LED, LOW);
    green.writePin(GREEN_CHORUS_1_LED, LOW);
    chorus2SWU = 0;
    chorus1SWU = 0;
    chorusOffSWU = 0;
  }

  if (!layerPatchFlag) {
    if (upperSW && chorus3SWU) {
      midiCCOut(MIDIchorusU, 65);
    }
    if (lowerSW && chorus3SWL) {
      midiCCOut(MIDIchorusL, 65);
    }
  }
}

void updatechorus2SW() {
  if (!recallPatchFlag) {
    showCurrentParameterPage("Chorus 2", "On");
  }
  if (chorus2SWL && lowerSW) {
    green.writePin(GREEN_CHORUS_3_LED, LOW);
    green.writePin(GREEN_CHORUS_2_LED, HIGH);
    green.writePin(GREEN_CHORUS_1_LED, LOW);
    sr.writePin(CHORUS_3_LED, LOW);
    sr.writePin(CHORUS_2_LED, LOW);
    sr.writePin(CHORUS_1_LED, LOW);
    chorus3SWL = 0;
    chorus1SWL = 0;
    chorusOffSWL = 0;
  }
  if (chorus2SWU && upperSW) {
    sr.writePin(CHORUS_3_LED, LOW);
    sr.writePin(CHORUS_2_LED, HIGH);
    sr.writePin(CHORUS_1_LED, LOW);
    green.writePin(GREEN_CHORUS_3_LED, LOW);
    green.writePin(GREEN_CHORUS_2_LED, LOW);
    green.writePin(GREEN_CHORUS_1_LED, LOW);
    chorus3SWU = 0;
    chorus1SWU = 0;
    chorusOffSWU = 0;
  }

  if (!layerPatchFlag) {
    if (upperSW && chorus2SWU) {
      midiCCOut(MIDIchorusU, 75);
    }
    if (lowerSW && chorus2SWL) {
      midiCCOut(MIDIchorusL, 75);
    }
  }
}

void updatechorus1SW() {
  if (!recallPatchFlag) {
    showCurrentParameterPage("Chorus 1", "On");
  }
  if (chorus1SWL && lowerSW) {
    green.writePin(GREEN_CHORUS_3_LED, LOW);
    green.writePin(GREEN_CHORUS_2_LED, LOW);
    green.writePin(GREEN_CHORUS_1_LED, HIGH);
    sr.writePin(CHORUS_3_LED, LOW);
    sr.writePin(CHORUS_2_LED, LOW);
    sr.writePin(CHORUS_1_LED, LOW);
    chorus3SWL = 0;
    chorus2SWL = 0;
    chorusOffSWL = 0;
  }
  if (chorus1SWU && upperSW) {
    sr.writePin(CHORUS_3_LED, LOW);
    sr.writePin(CHORUS_2_LED, LOW);
    sr.writePin(CHORUS_1_LED, HIGH);
    green.writePin(GREEN_CHORUS_3_LED, LOW);
    green.writePin(GREEN_CHORUS_2_LED, LOW);
    green.writePin(GREEN_CHORUS_1_LED, LOW);
    chorus3SWU = 0;
    chorus2SWU = 0;
    chorusOffSWU = 0;
  }

  if (!layerPatchFlag) {
    if (upperSW && chorus1SWU) {
      midiCCOut(MIDIchorusU, 85);
    }
    if (lowerSW && chorus1SWL) {
      midiCCOut(MIDIchorusL, 85);
    }
  }
}

void updatechorusOffSW() {
  if (!recallPatchFlag) {
    showCurrentParameterPage("Chorus", "Off");
  }
  if (chorusOffSWL && lowerSW) {
    green.writePin(GREEN_CHORUS_3_LED, LOW);
    green.writePin(GREEN_CHORUS_2_LED, LOW);
    green.writePin(GREEN_CHORUS_1_LED, LOW);
    sr.writePin(CHORUS_3_LED, LOW);
    sr.writePin(CHORUS_2_LED, LOW);
    sr.writePin(CHORUS_1_LED, LOW);
    chorus3SWL = 0;
    chorus2SWL = 0;
    chorus1SWL = 0;
  }
  if (chorusOffSWU && upperSW) {
    sr.writePin(CHORUS_3_LED, LOW);
    sr.writePin(CHORUS_2_LED, LOW);
    sr.writePin(CHORUS_1_LED, LOW);
    green.writePin(GREEN_CHORUS_3_LED, LOW);
    green.writePin(GREEN_CHORUS_2_LED, LOW);
    green.writePin(GREEN_CHORUS_1_LED, LOW);
    chorus3SWU = 0;
    chorus2SWU = 0;
    chorus1SWU = 0;
  }

  if (!layerPatchFlag) {
    if (upperSW && chorusOffSWU) {
      midiCCOut(MIDIchorusU, 97);
    }
    if (lowerSW && chorusOffSWL) {
      midiCCOut(MIDIchorusL, 97);
    }
  }
}

void updateosc1_1SW() {
  if (!recallPatchFlag) {
    showCurrentParameterPage("OSC1", "1 Foot");
  }
  if (osc1_1SWL && lowerSW) {
    green.writePin(GREEN_OSC1_1_LED, HIGH);
    green.writePin(GREEN_OSC1_2_LED, LOW);
    green.writePin(GREEN_OSC1_4_LED, LOW);
    green.writePin(GREEN_OSC1_8_LED, LOW);
    green.writePin(GREEN_OSC1_16_LED, LOW);
    sr.writePin(OSC1_1_LED, LOW);
    sr.writePin(OSC1_2_LED, LOW);
    sr.writePin(OSC1_4_LED, LOW);
    sr.writePin(OSC1_8_LED, LOW);
    sr.writePin(OSC1_16_LED, LOW);
    osc1_2SWL = 0;
    osc1_4SWL = 0;
    osc1_8SWL = 0;
    osc1_16SWL = 0;
  }
  if (osc1_1SWU && upperSW) {
    sr.writePin(OSC1_1_LED, HIGH);
    sr.writePin(OSC1_2_LED, LOW);
    sr.writePin(OSC1_4_LED, LOW);
    sr.writePin(OSC1_8_LED, LOW);
    sr.writePin(OSC1_16_LED, LOW);
    green.writePin(GREEN_OSC1_1_LED, LOW);
    green.writePin(GREEN_OSC1_2_LED, LOW);
    green.writePin(GREEN_OSC1_4_LED, LOW);
    green.writePin(GREEN_OSC1_8_LED, LOW);
    green.writePin(GREEN_OSC1_16_LED, LOW);
    osc1_2SWU = 0;
    osc1_4SWU = 0;
    osc1_8SWU = 0;
    osc1_16SWU = 0;
  }

  if (!layerPatchFlag) {
    if (upperSW && osc1_1SWU) {
      midiCCOut(MIDIosc1FootU, 65);
    }
    if (lowerSW && osc1_1SWL) {
      midiCCOut(MIDIosc1FootL, 65);
    }
  }
}

void updateosc1_2SW() {
  if (!recallPatchFlag) {
    showCurrentParameterPage("OSC1", "2 Foot");
  }
  if (osc1_2SWL && lowerSW) {
    green.writePin(GREEN_OSC1_1_LED, LOW);
    green.writePin(GREEN_OSC1_2_LED, HIGH);
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
    green.writePin(GREEN_OSC2_1_LED, LOW);
    green.writePin(GREEN_OSC2_2_LED, LOW);
    green.writePin(GREEN_OSC2_4_LED, LOW);
    green.writePin(GREEN_OSC2_8_LED, LOW);
    green.writePin(GREEN_OSC2_16_LED, LOW);
    osc2_2SWU = 0;
    osc2_4SWU = 0;
    osc2_8SWU = 0;
    osc2_16SWU = 0;
  }

  if (!layerPatchFlag) {
    if (upperSW && osc2_1SWU) {
      midiCCOut(MIDIosc2FootU, 65);
    }
    if (lowerSW && osc2_1SWL) {
      midiCCOut(MIDIosc2FootL, 65);
    }
  }
}
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
void loop() {
  myusb.Task();
  midi1.read();  //USB HOST MIDI Class Compliant
  MIDI.read(midiChannel);
  usbMIDI.read(midiChannel);
  checkMux();           // Read the sliders and switches
  checkSwitches();      // Read the buttons for the program menus etc
  checkEncoder();       // check the encoder status
  octoswitch.update();  // read all the buttons for the Synthex
  sr.update();          // update all the RED LEDs in the buttons
  green.update();       // update all the GREEN LEDs in the buttons
  checkEEPROM();        // check anything that may have changed form the initial startup
  stopLEDs();           // blink the wave LEDs once when pressed
  sendEscapeKey();
  //convertIncomingNote();                 // read a note when in learn mode and use it to set the values
}
