craigyjp/Elka-X-VST-editor---Cherry-Audio/src/ButtonsPots.h

#define CCmodWheelinput 1
#define CCmasterTune 2
#define CClayerPan 3
#define CClayerVolume 4
#define CCreverbLevel 5
#define CCreverbDecay 6
#define CCmasterVolume 7
#define CCreverbEQ 8
#define CCarpFrequency 9
#define CCampVelocity 10  

#define CCfilterVelocity 12
#define CCampRelease 13
#define CCampSustain 14
#define CCampDecay 15
#define CCampAttack 16
#define CCfilterKeyboard 17
#define CCfilterResonance  18
#define CCosc2Volume 19
#define CCosc2PW  20
#define CCosc1PW  21
#define CCosc1Volume  22
#define CCfilterCutoff 23
#define CCfilterEnvAmount 24
#define CCfilterAttack 25
#define CCfilterDecay  26
#define CCfilterSustain  27
#define CCfilterRelease 28
#define CCechoEQ 29
#define CCechoLevel 54
#define CCechoFeedback 31

#define CCechoSpread 33
#define CCechoTime 34
#define CClfo2UpperLower 35
#define CCunisonDetune 36
#define CCglideSpeed  37
#define CCosc1Transpose  38
#define CCosc2Transpose 39
#define CCnoiseLevel  40
#define CCglideAmount 41
#define CCosc1Tune 42
#define CCosc2Tune  43
#define CCbendToFilter  44
#define CClfo2ToFilter 45
#define CCbendToOsc  46
#define CClfo2ToOsc  47
#define CClfo2FreqAcc  48
#define CClfo2InitFrequency 49
#define CClfo2InitAmount  50
#define CCseqAssign 51
#define CCseqRate  52
#define CCseqGate  53
#define CClfo1Frequency 30
#define CClfo1DepthA 55
#define CClfo1Delay 56
#define CClfo1DepthB 57
#define CClowerSW  58
#define CCupperSW  59
#define CCutilitySW 60 
#define CCarpSyncSW 61
#define CCarpHoldSW 62
#define CClayerSoloSW 63
#define CCmaxVoicesSW 67
#define CCmaxVoicesExitSW 68
#define CCenvInvSW 70
#define CCfilterHPSW 71
#define CCfilterBP2SW 72
#define CCfilterBP1SW 73
#define CCfilterLP2SW 74
#define CCfilterLP1SW 75
#define CCrevGLTCSW  76
#define CCrevHallSW  77
#define CCrevPlateSW  78
#define CCrevRoomSW  79
#define CCrevOffSW 80
#define CCnoisePinkSW 81
#define CCnoiseWhiteSW  82
#define CCnoiseOffSW 83
#define CCechoSyncSW 84
#define CCosc2ringModSW 85
#define CCosc1ringModSW 86
#define CCosc1_osc2PWMSW 87
#define CCosc1pulseSW 88
#define CCosc1squareSW 89
#define CCosc1sawSW 90
#define CCosc1triangleSW 91
#define CCosc2_osc1PWMSW 92
#define CCosc2pulseSW 93
#define CCosc2squareSW 94
#define CCosc2sawSW 95
#define CCosc2triangleSW 96
#define CCechoPingPongSW 97
#define CCechoTapeSW 98
#define CCechoSTDSW 99
#define CCechoOffSW 100
#define CCchorus3SW 101
#define CCchorus2SW 102
#define CCchorus1SW 103
#define CCchorusOffSW 104
#define CClimiterSW 105
#define CClfo1SyncSW 106
#define CClfo1modWheelSW 107
#define CClfo2SyncSW 108
#define CClfo1randSW 109
#define CClfo1resetSW 110
#define CClfo1osc1SW 111
#define CClfo1osc2SW 112
#define CClfo1pw1SW 113
#define CClfo1pw2SW 114
#define CCosc1glideSW 115
#define CCosc2glideSW 116
#define CCportSW 117
#define CCglideSW 118
#define CCglideOffSW 119
#define CCosc2SyncSW 120
#define CCmultiTriggerSW 122
#define CClfo1filtSW  121
#define CClfo1ampSW  124
#define CClfo1seqRateSW  125
#define CClfo1squareUniSW 126
#define CClfo1squareBipSW 127
#define CCarpRange4SW 128
#define CCarpRange3SW 129
#define CCarpRange2SW 130
#define CCarpRange1SW 131
#define CCsingleSW 132
#define CCdoubleSW 133
#define CCsplitSW 134
#define CCpolySW 135
#define CCsingleMonoSW 136
#define CCunisonMonoSW 137
#define CClfo1triangleSW 138
#define CCosc1_1SW 139
#define CCosc1_2SW 140
#define CCosc1_4SW 141
#define CCosc1_8SW 142
#define CCosc1_16SW 143
#define CCosc2_1SW 144
#define CCosc2_2SW 145
#define CCosc2_4SW 146
#define CCosc2_8SW 147
#define CCosc2_16SW 148
#define CCarpRandSW 149 
#define CCarpUpDownSW 150
#define CCarpDownSW 151
#define CCarpUpSW 152
#define CCarpOffSW  153
#define CClfo1sawUpSW 154
#define CClfo1sawDnSW 155
#define CCchordMemorySW 156
#define CCsplitLearning 157
#define CCutilityAction 158
#define CCseqPlaySW 159
#define CCseqStopSW 160
#define CCseqKeySW 161
#define CCseqTransSW 162
#define CCseqLoopSW 163
#define CCseqFwSW 164
#define CCseqBwSW 165
#define CCseqEnable1SW 166
#define CCseqEnable2SW 167
#define CCseqEnable3SW 168
#define CCseqEnable4SW 169
#define CCseqSyncSW 170
#define CCseqrecEditSW 171
#define CCseqinsStepSW 172
#define CCseqdelStepSW 173
#define CCseqaddStepSW 174
#define CCseqRestSW 175
#define CCseqUtilSW 176
