craigyjp/Elka-X-VST-editor---Cherry-Audio/src/Constants.h

const char* VERSION = "V1.4";

const float SYNTHEXBENDTOOSC[128] = {0.00, 0.09, 0.19, 0.28, 0.38, 0.47, 0.57, 0.66, 0.76, 0.85, 0.94, 1.04, 1.13, 1.23, 1.32, 1.42, 1.51, 1.61, 1.70, 1.80, 1.89, 1.98, 2.08, 2.17, 2.27, 2.36, 2.46, 2.55, 2.65, 2.74, 2.83, 2.93, 3.02, 3.12, 3.21, 3.31, 3.40, 3.50, 3.59, 3.69, 3.78, 3.87, 3.97, 4.06, 4.16, 4.25, 4.35, 4.44, 4.54, 4.63, 4.72, 4.82, 4.91, 5.01, 5.10, 5.20, 5.29, 5.39, 5.48, 5.57, 5.67, 5.76, 5.86, 5.95, 6.05, 6.14, 6.24, 6.33, 6.43, 6.52, 6.61, 6.71, 6.80, 6.90, 6.99, 7.09, 7.18, 7.28, 7.37, 7.46, 7.56, 7.65, 7.75, 7.84, 7.94, 8.03, 8.13, 8.22, 8.31, 8.41, 8.50, 8.60, 8.69, 8.79, 8.88, 8.98, 9.07, 9.17, 9.26, 9.35, 9.45, 9.54, 9.64, 9.73, 9.83, 9.92, 10.02, 10.11, 10.20, 10.30, 10.39, 10.49, 10.58, 10.68, 10.77, 10.87, 10.96, 11.06, 11.15, 11.24, 11.34, 11.43, 11.53, 11.62, 11.72, 11.81, 11.91, 12.00};
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
const String INITPATCH = "CC Mode,1,1,1,1,1,1,1,1,1,1,1,1,1,1,1,1,1,1,1,1,1,1,1,1,1,1,1,1,1,1,1,1,1,1,1,1,1,1,1,1,1,1,1,1,1,1,1,1,1,1,1,1,1,1,1,1,1,1,1,1,1,1,1,1,1,1,1,1,1,1,1,1,1,1,1,1,1,1,1,1,1,1,1,1,1,1,1,1,1,1,1,1,1,1,1,1,1,1,1,1,1,1,1,1,1,1,1,1,1,1,1,1,1,1,1,1,1,1,1";
