craigyjp/Elka-X-VST-editor---Cherry-Audio/(commit log)

2023-12-29 Added LFO1 buttons
2023-12-29 Added all LFO1 buttons
2023-12-29 Fixed the radio group multiple MIDI messages output on recall
    [Synthex.ino]
2023-12-30 Added Sync functions and button press fixes
    [Constants.h, Parameters.h, Synthex.ino]
2023-12-30 Added Limiter Switch
2024-01-02 Calibrated pot percentages
2024-01-04 Completed pot mappings and fixed a few bugs
    [Constants.h, Parameters.h, Synthex.ino]
2024-01-23 A few bug fixes for notes used to map parameters
    [Constants.h, ST7735Display.h, Synthex.ino]
2024-01-23 Added LED Displays
2024-01-24 Fixed the keyboard split fault
    [MidiCC.h, Synthex.ino]
2024-01-26 Added seq buttons but not functions
2024-02-19 Added code MIDI out 6 for CC messages to HID
    To enable the sequencer functions I needed more controls, MIDI to HID converter provides upto 36 buttons
2024-02-19 Added main board & midi interfaces
